PI2-PLG/PLG-Docs/assets/img/about/abt-left-img.jpeg

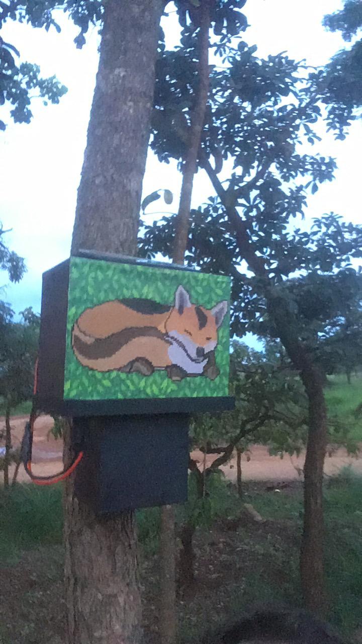
assets/img/about/abt-left-img.jpeg
