PI2-PLG/PLG-Docs/README.md

<p align="center">
  
</p>

# Projeto Lobo-Guará - Docs
### Sistema de monitoramento de queimadas feito por alunos da Universidade de Brasília.

Este repositório é o responsável pela documentação do projeto.
