PI2-PLG/PLG-Docs/Documentos do Projeto/comunicação/README.md

<p align="center">
  
</p>

# Projeto Lobo-Guará - NodeRed
### Sistema de monitoramento de queimadas feito por alunos da Universidade de Brasília.

Este repositório que contém o código de comunicação software-eletrônica.
