PI2-PLG/PLG-Docs/Documentos do Projeto/Eletronica/Esquemáticos/Nobreak_15x20.pdf

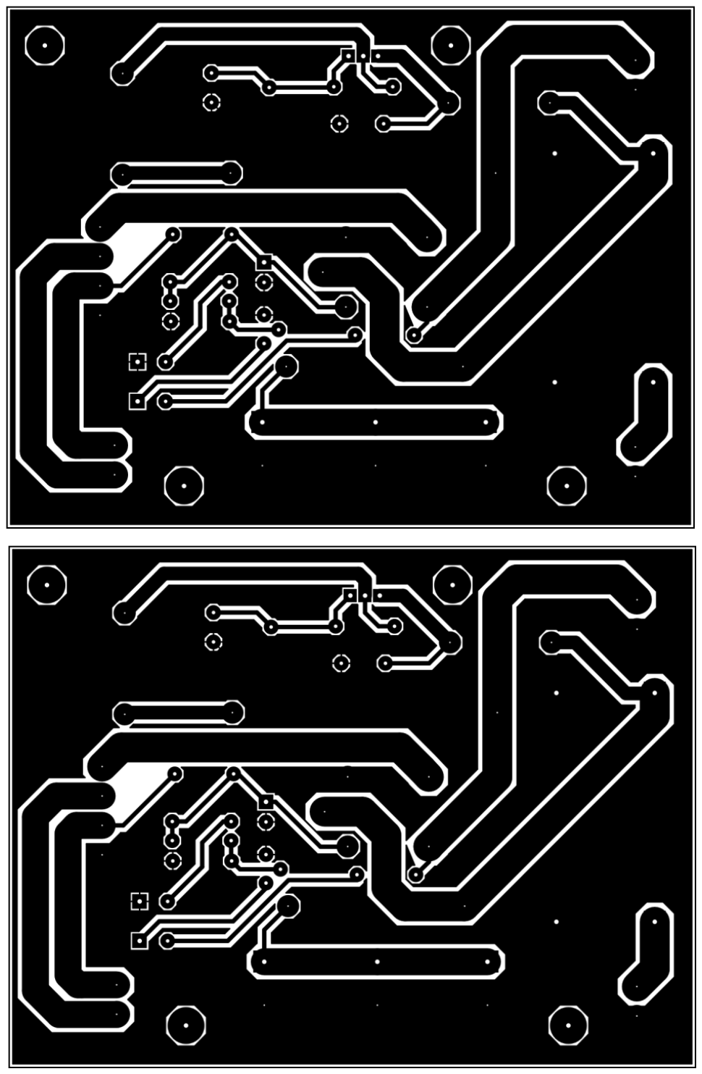
[picture p3: page 1]
