PI2-PLG/PLG-Docs/Documentos do Projeto/Eletronica/Esquemáticos/placa_Principal_15x20.pdf

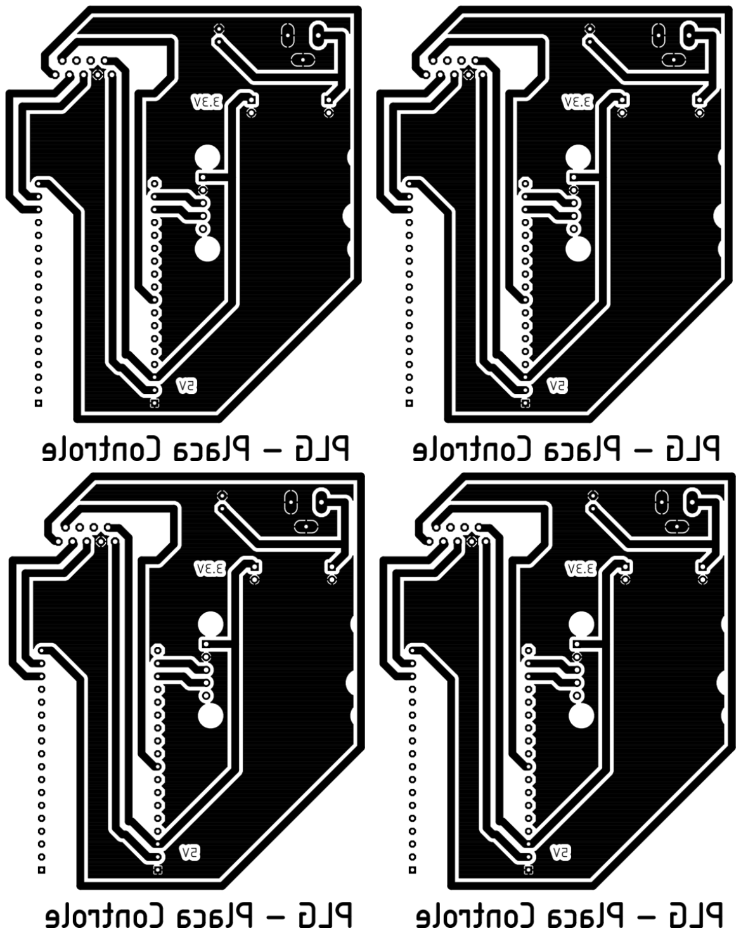
[picture p4: page 1]
