PI2-PLG/PLG-Docs/Documentos do Projeto/Eletronica/Esquemáticos/sensorfinal_15x20.pdf

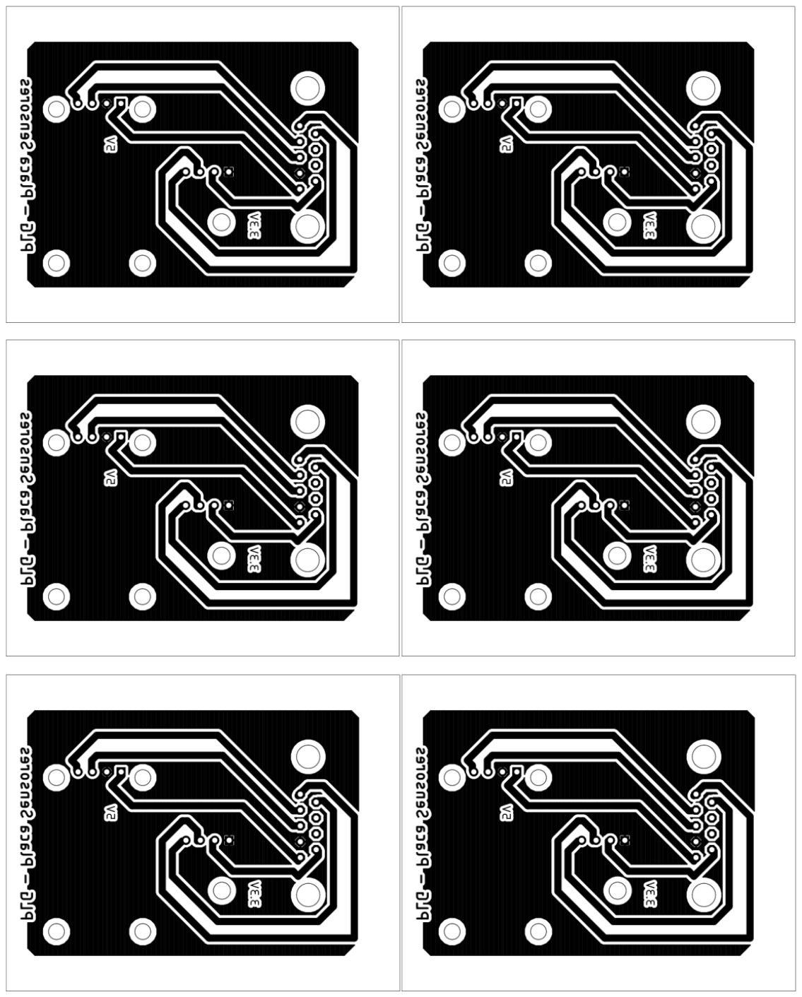
[picture p5: page 1]
