PI2-PLG/PLG-Docs/assets/img/mobile/ft-screen-img.jpg

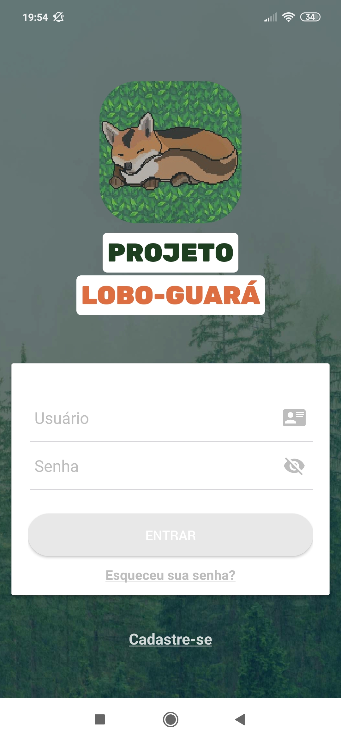
assets/img/mobile/ft-screen-img.jpg
