PI2-PLG/PLG-Docs/assets/img/mobile/screen-slider/chart.jpg

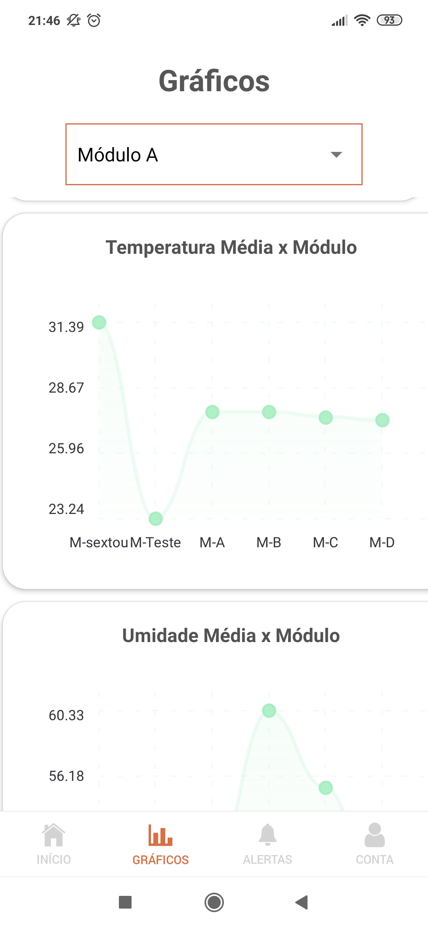
assets/img/mobile/screen-slider/chart.jpg
