PI2-PLG/PLG-Docs/assets/img/mobile/screen-slider/createaccount.jpg

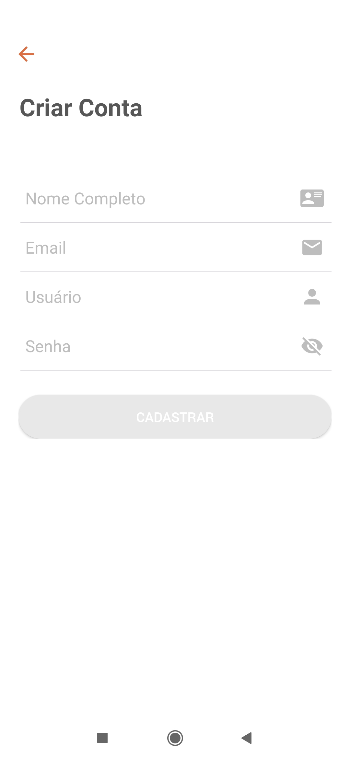
assets/img/mobile/screen-slider/createaccount.jpg
