PI2-PLG/PLG-Docs/assets/img/mobile/screen-slider/profile1.jpg

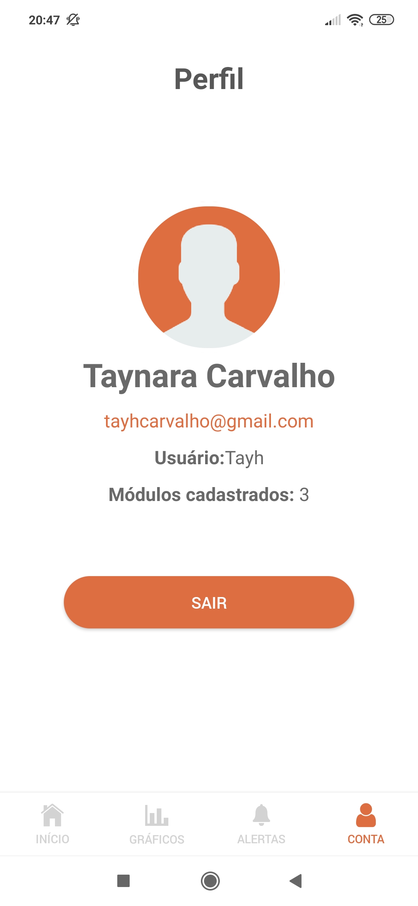
assets/img/mobile/screen-slider/profile1.jpg
