PI2-PLG/PLG-Docs/assets/img/mobile/screen-slider/screen2.jpg

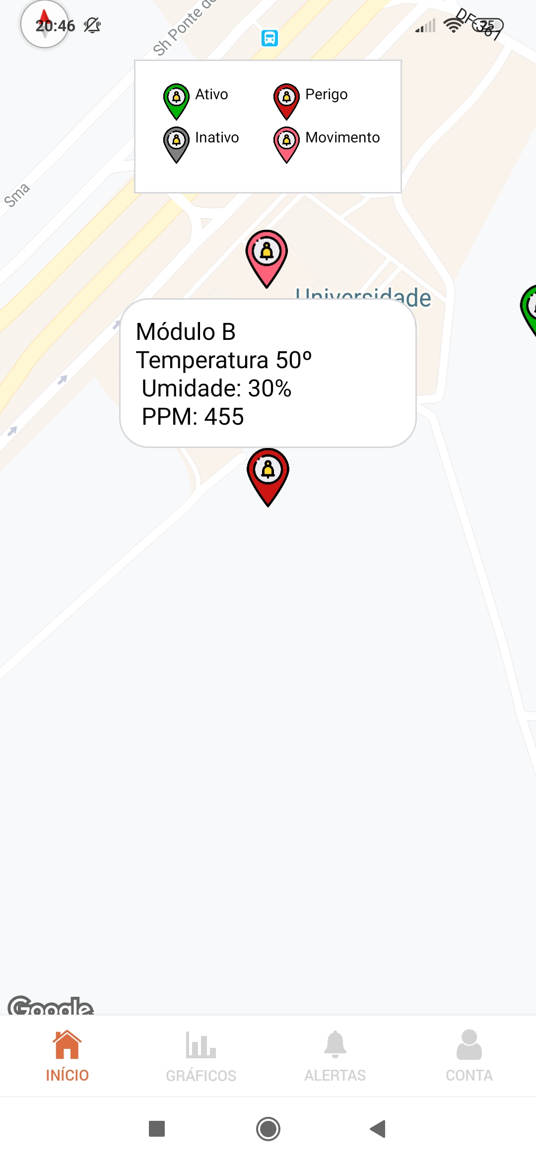
assets/img/mobile/screen-slider/screen2.jpg
