PI2-PLG/PLG-Docs/assets/img/mobile/screen-slider/screen3.jpg

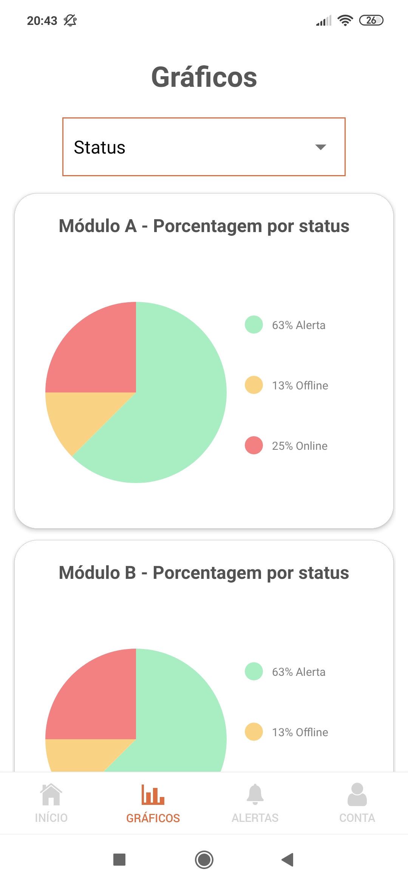
assets/img/mobile/screen-slider/screen3.jpg
