PI2-PLG/PLG-Docs/assets/img/mobile/screen-slider/screen4.jpg

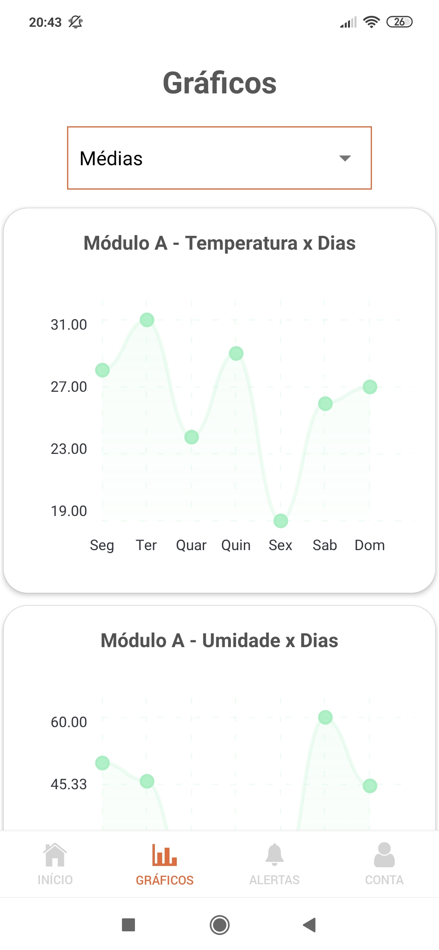
assets/img/mobile/screen-slider/screen4.jpg
