PI2-PLG/PLG-Docs/assets/img/mobile/screen-slider/screen5.jpg

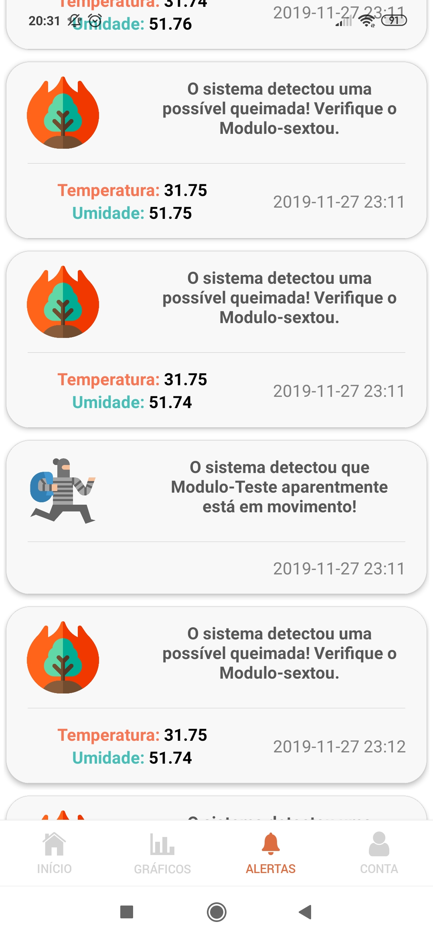
assets/img/mobile/screen-slider/screen5.jpg
