PI2-PLG/PLG-Docs/Documentos do Projeto/Eletronica/D1.png

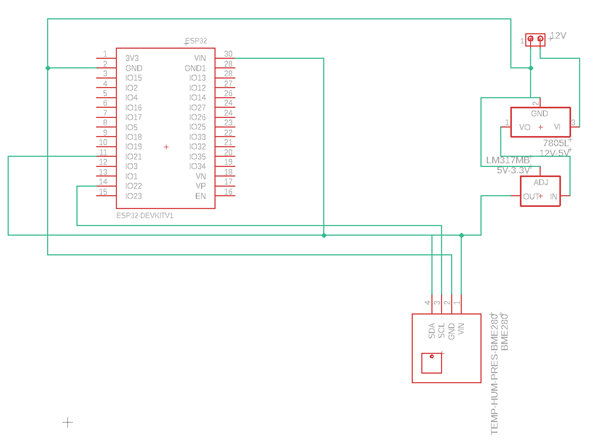
Documentos do Projeto/Eletronica/D1.png
