PI2-PLG/PLG-Docs/Documentos do Projeto/Eletronica/D2.png

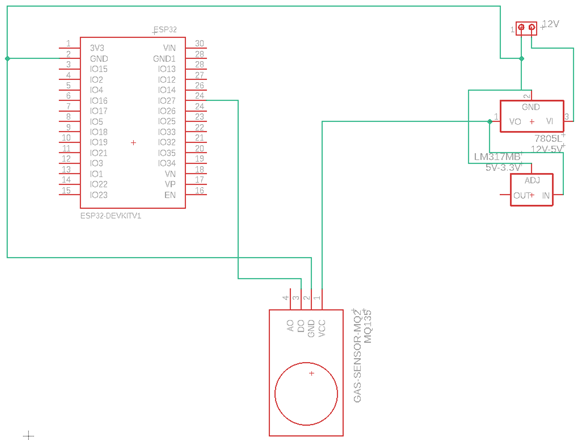
Documentos do Projeto/Eletronica/D2.png
