PI2-PLG/PLG-Docs/Documentos do Projeto/Eletronica/D3.png

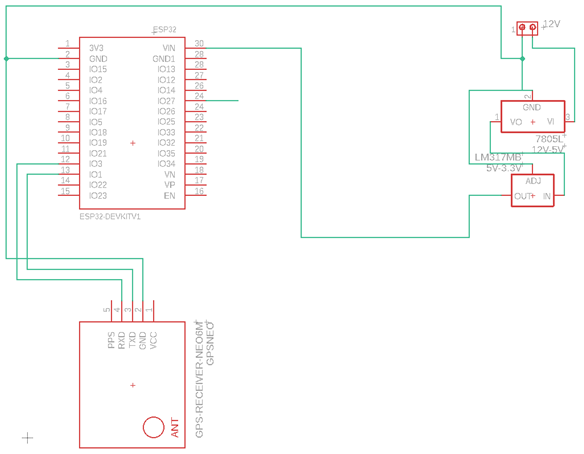
Documentos do Projeto/Eletronica/D3.png
