PI2-PLG/PLG-Docs/Documentos do Projeto/Eletronica/D4.png

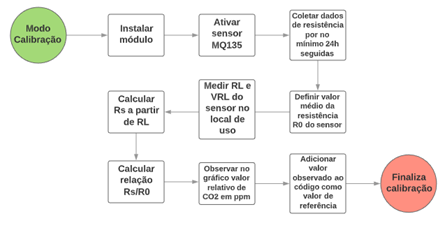
Documentos do Projeto/Eletronica/D4.png
