PI2-PLG/PLG-Docs/Documentos do Projeto/Eletronica/D5.png

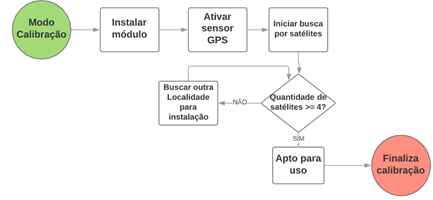
Documentos do Projeto/Eletronica/D5.png
