PI2-PLG/PLG-Docs/Documentos do Projeto/Eletronica/Desing_PCB.jpg

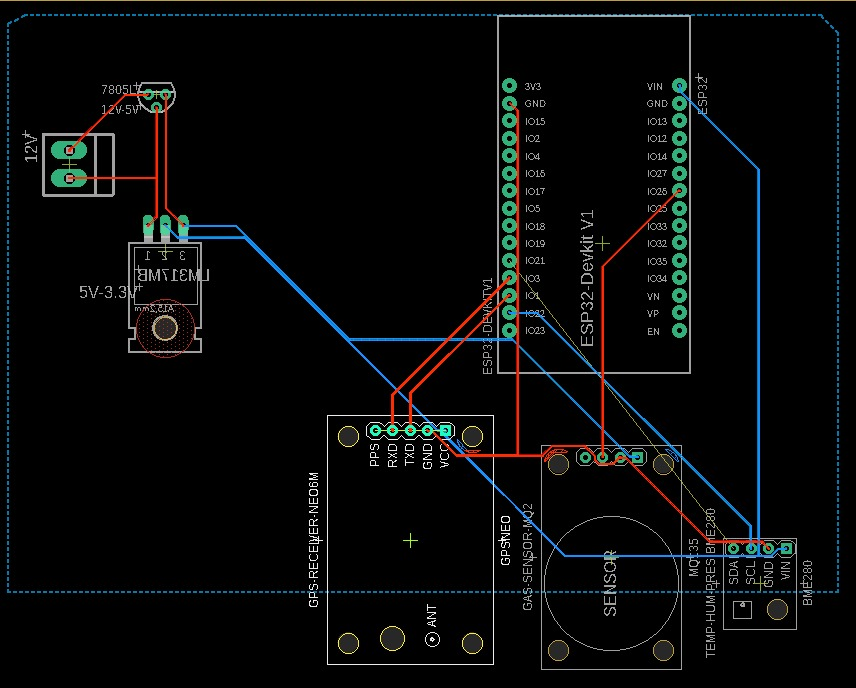
Documentos do Projeto/Eletronica/Desing_PCB.jpg
