PI2-PLG/PLG-Docs/Documentos do Projeto/Eletronica/petri.JPG

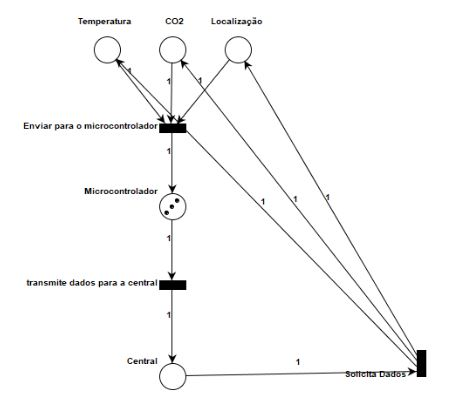
Documentos do Projeto/Eletronica/petri.JPG
