PI2-PLG/PLG-Docs/Documentos do Projeto/Eletronica/vista3D.jpg

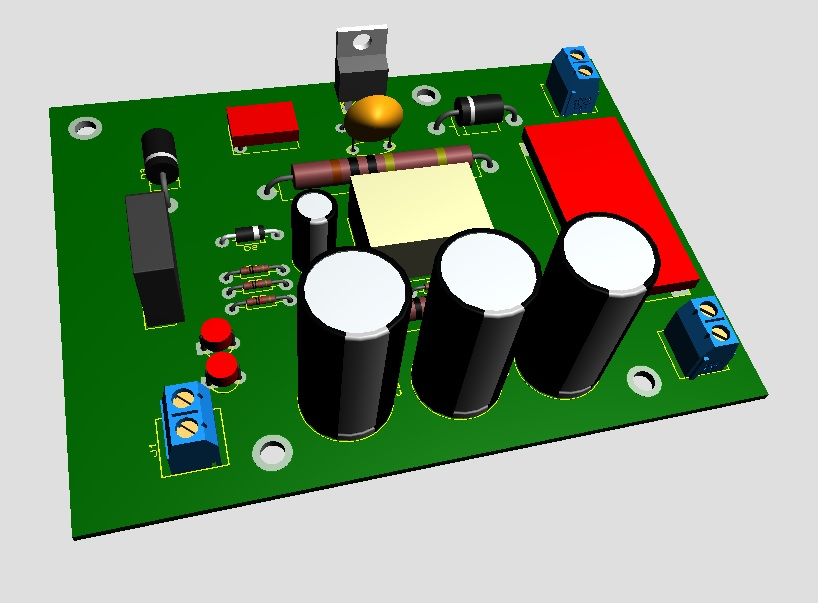
Documentos do Projeto/Eletronica/vista3D.jpg
