PI2-PLG/PLG-Docs/Documentos do Projeto/Energia/Esquemático nobreak.jpg

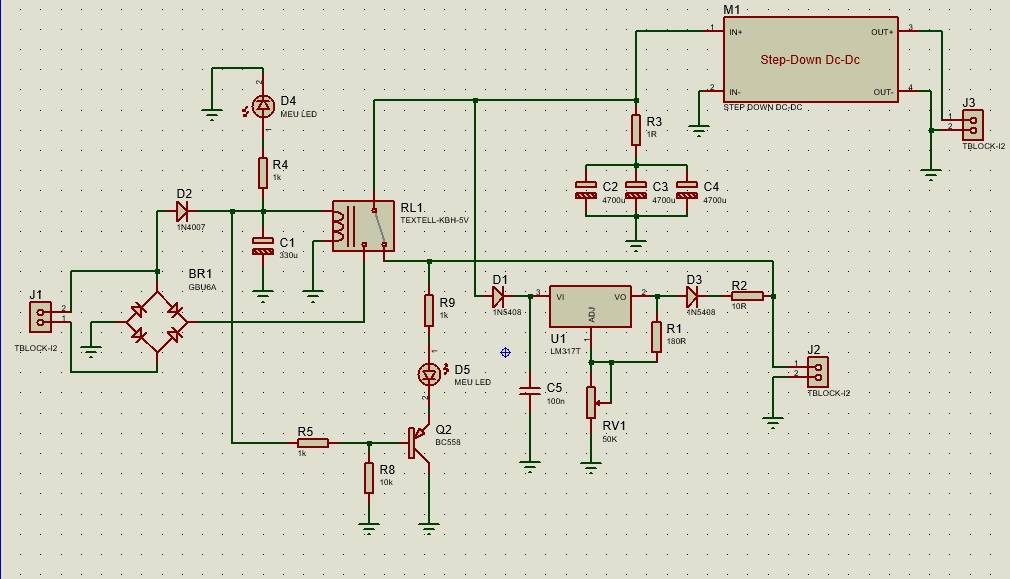
Documentos do Projeto/Energia/Esquemático nobreak.jpg
