PI2-PLG/PLG-Docs/Documentos do Projeto/Energia/Layout placa nobreak.jpg

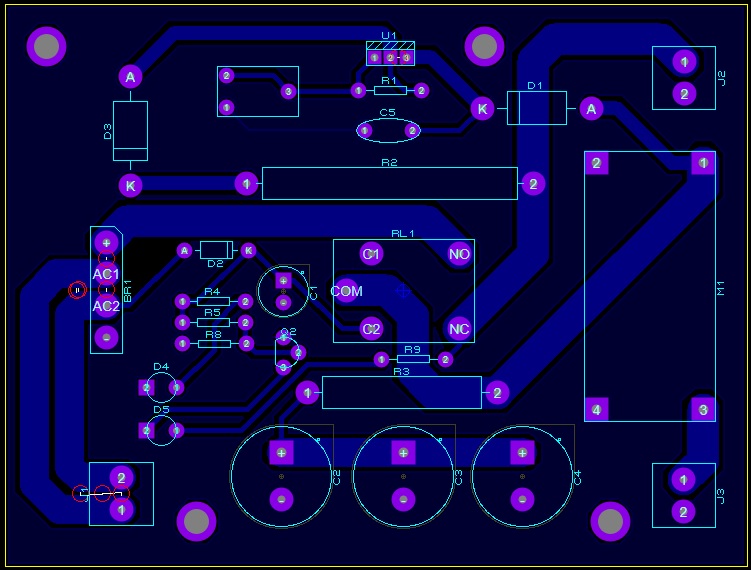
Documentos do Projeto/Energia/Layout placa nobreak.jpg
