PI2-PLG/PLG-Docs/Documentos do Projeto/Energia/Vista lado cobreado placa nobreak.jpg

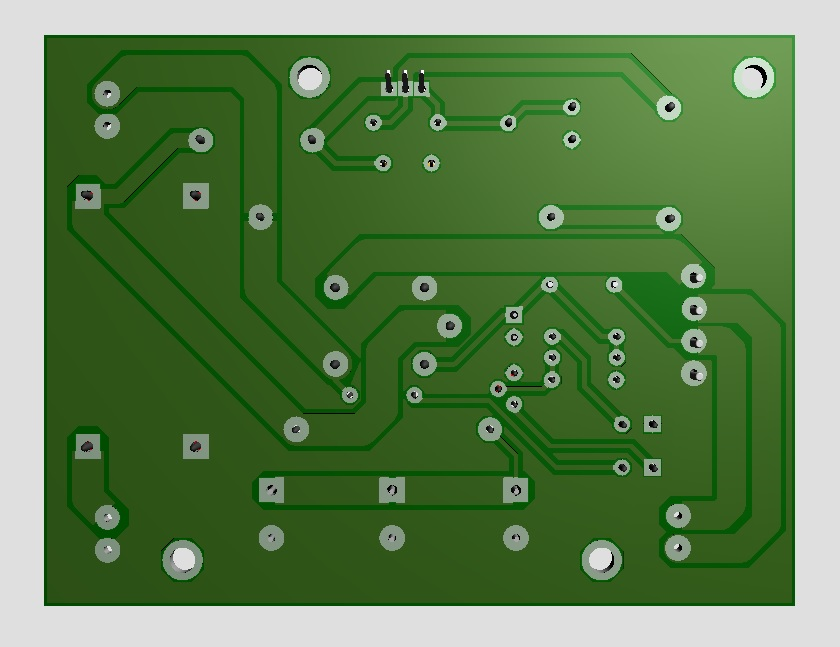
Documentos do Projeto/Energia/Vista lado cobreado placa nobreak.jpg
