PI2-PLG/PLG-Docs/Documentos do Projeto/FolhaDoProduto.png

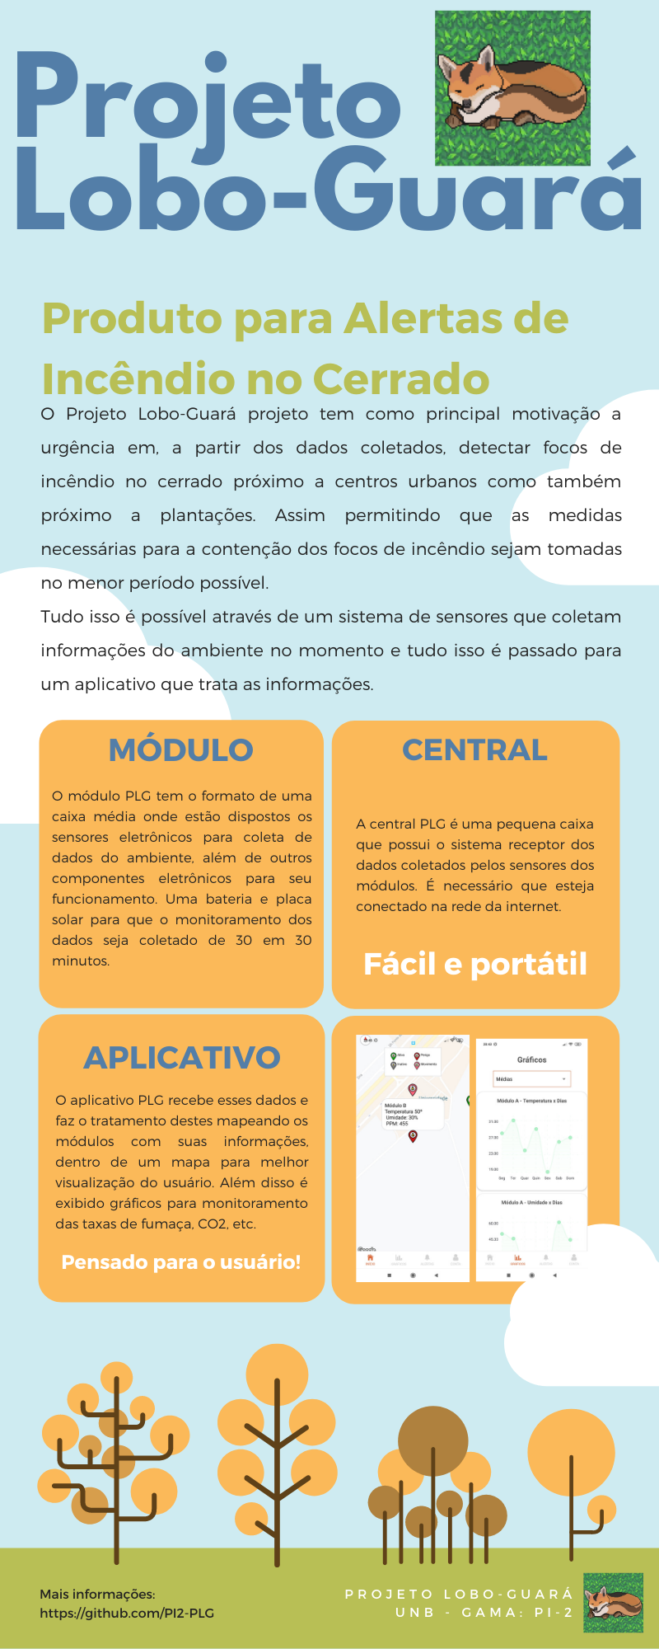
Documentos do Projeto/FolhaDoProduto.png
