PI2-PLG/PLG-Docs/Documentos do Projeto/Projeto Lobo-Guará/Arquitetura.png

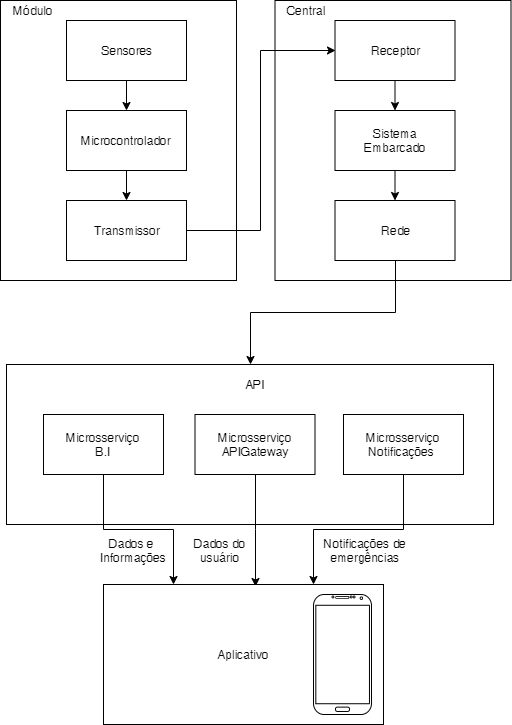
Documentos do Projeto/Projeto Lobo-Guará/Arquitetura.png
