PI2-PLG/PLG-Docs/Documentos do Projeto/Projeto Lobo-Guará/Diagrama Integração PLG.png

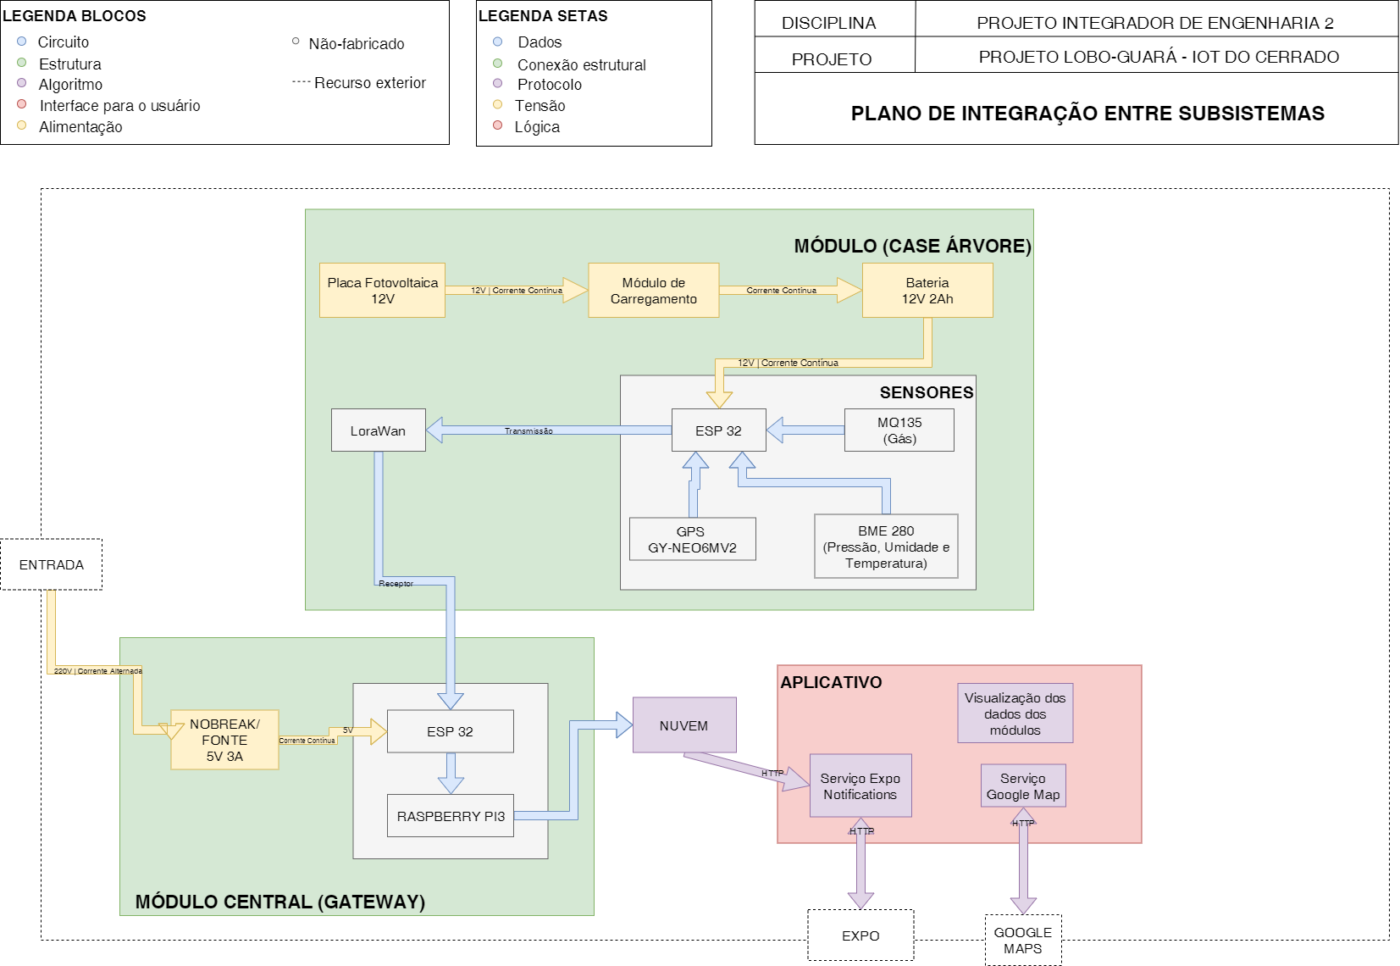
Documentos do Projeto/Projeto Lobo-Guará/Diagrama Integração PLG.png
