PI2-PLG/PLG-Docs/Documentos do Projeto/Projeto Lobo-Guará/EAP.png

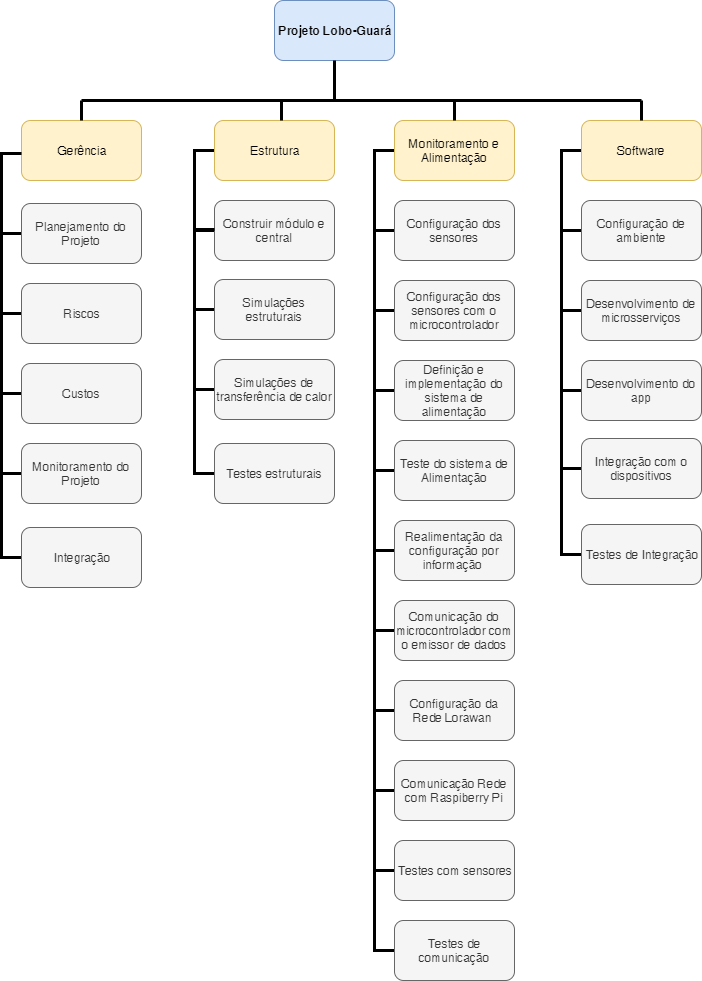
Documentos do Projeto/Projeto Lobo-Guará/EAP.png
