PI2-PLG/PLG-Docs/Documentos do Projeto/Software/Comunicação.png

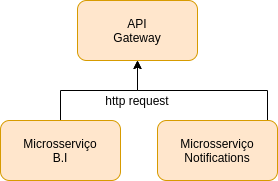
Documentos do Projeto/Software/Comunicação.png
