PI2-PLG/PLG-Docs/Documentos do Projeto/Software/D. Sequência.png

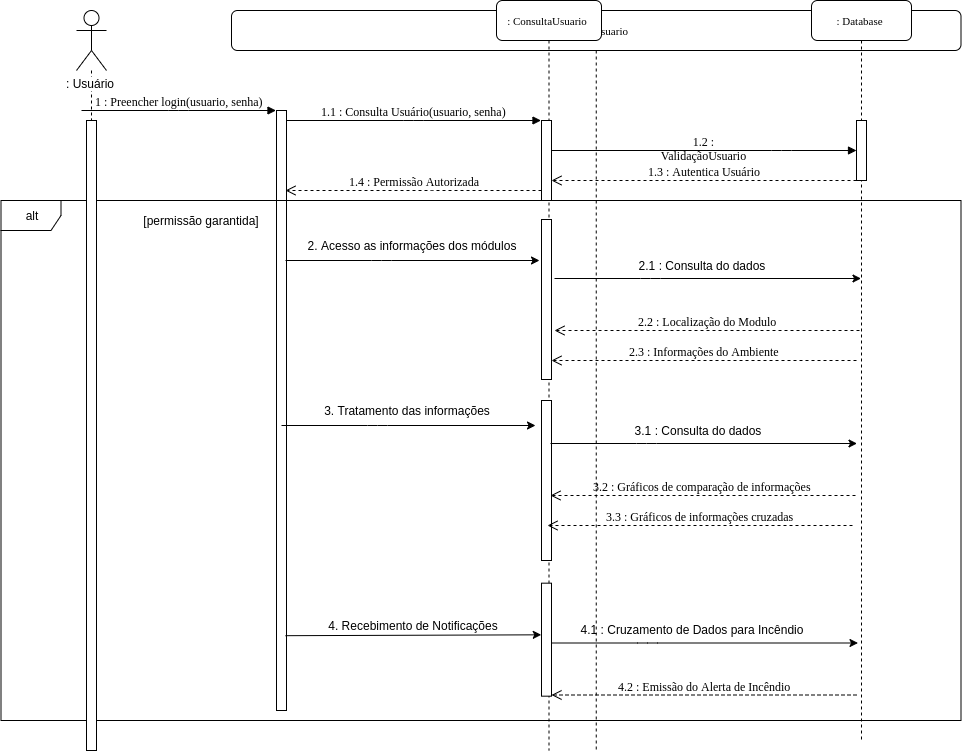
Documentos do Projeto/Software/D. Sequência.png
