PI2-PLG/PLG-Docs/Documentos do Projeto/Software/diagrama_casos_de_uso_lobo_guara.png

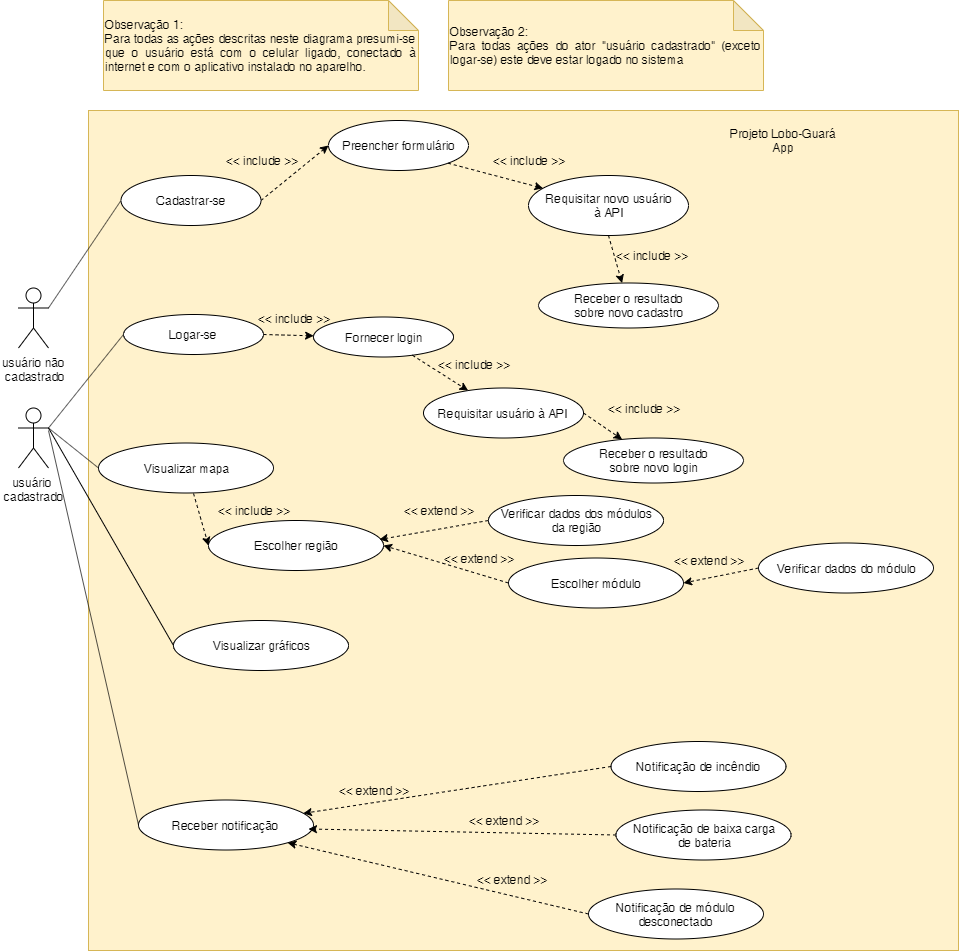
Documentos do Projeto/Software/diagrama_casos_de_uso_lobo_guara.png
