PI2-PLG/PLG-Docs/Documentos do Projeto/Software/diagramaclassesloboguara.png

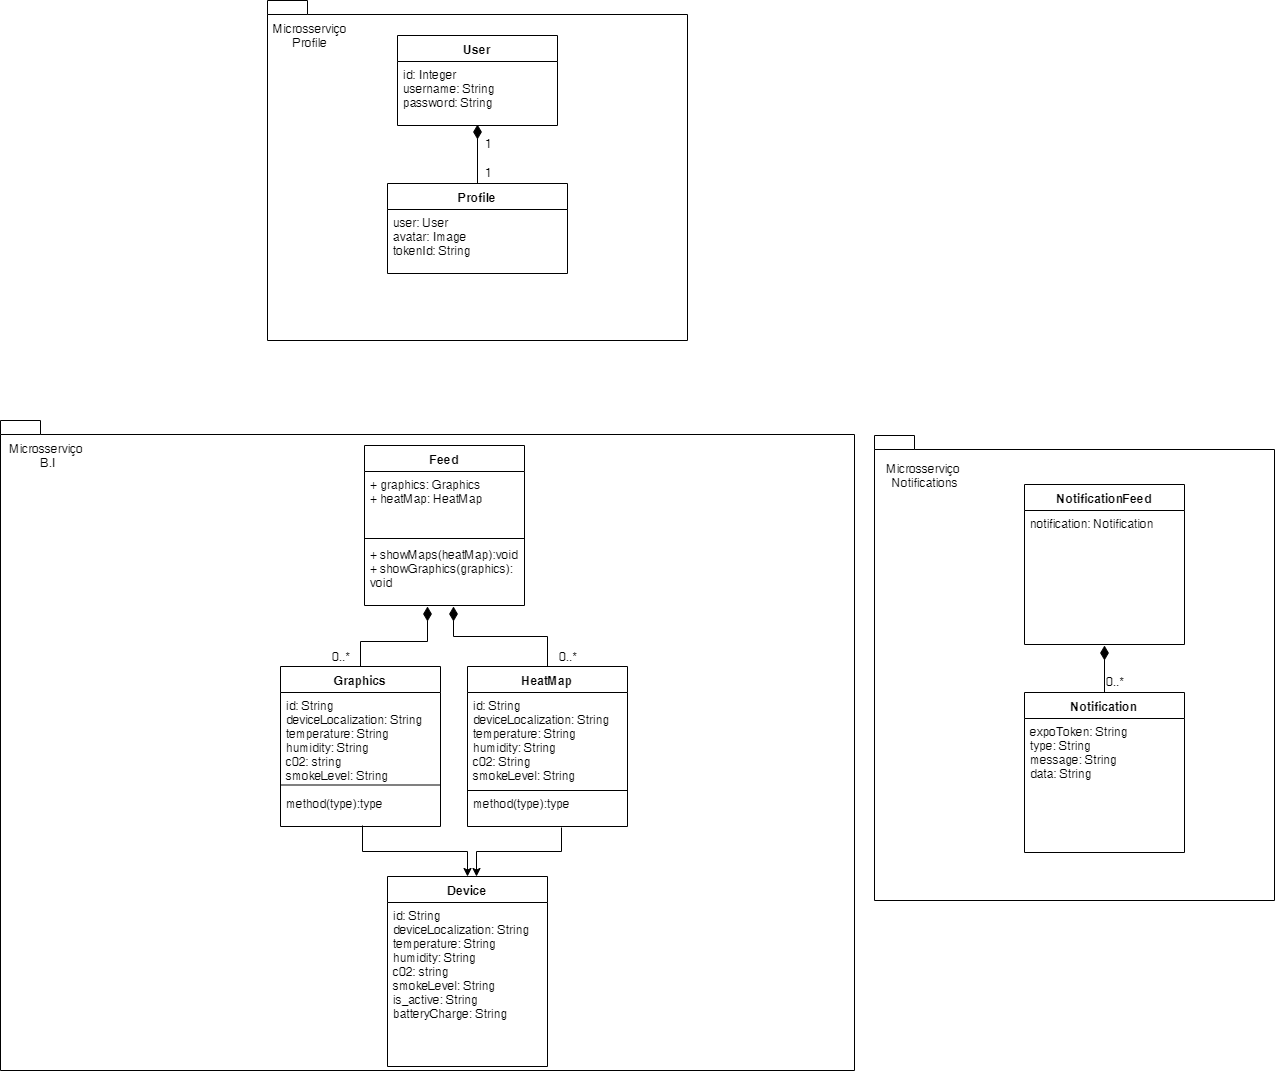
Documentos do Projeto/Software/diagramaclassesloboguara.png
