PI2-PLG/PLG-Docs/Documentos do Projeto/Software/EAP do Produto.png

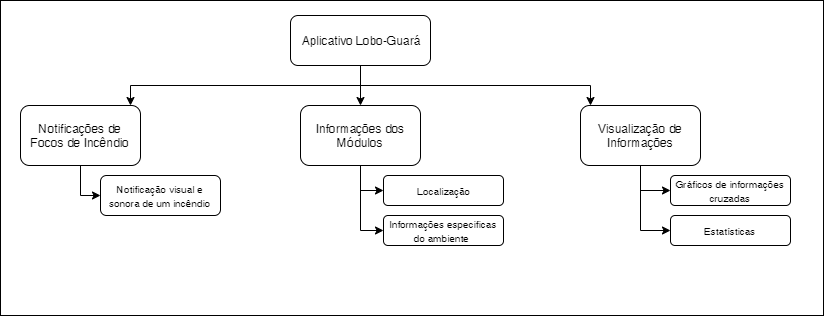
Documentos do Projeto/Software/EAP do Produto.png
