PI2-PLG/PLG-Docs/Documentos do Projeto/Software/integracaosoftwareeletronica.png

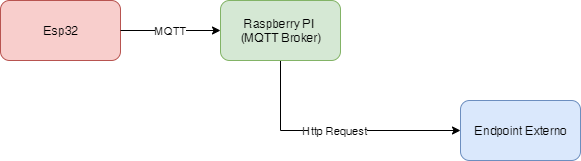
Documentos do Projeto/Software/integracaosoftwareeletronica.png
