PI2-PLG/PLG-Docs/Documentos do Projeto/Software/nfr confiabilidade.png

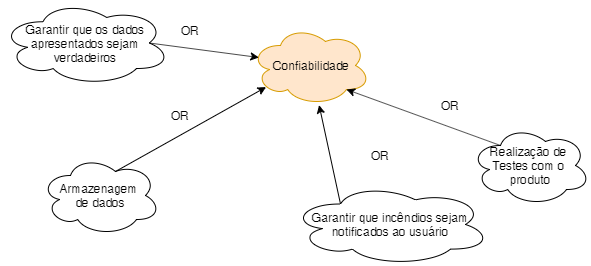
Documentos do Projeto/Software/nfr confiabilidade.png
