PI2-PLG/PLG-Docs/Documentos do Projeto/Software/nfr usabilidade.png

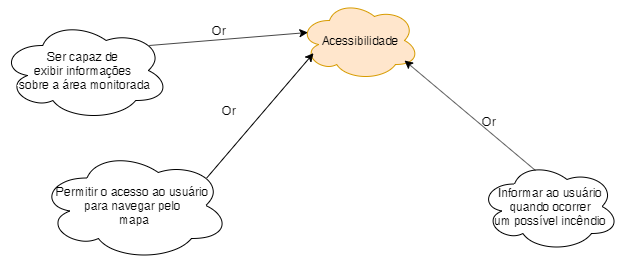
Documentos do Projeto/Software/nfr usabilidade.png
