PI2-PLG/PLG-Docs/Documentos do Projeto/Software/nfrescalabilidade.png

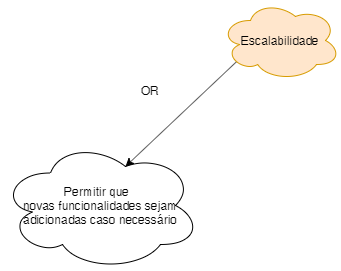
Documentos do Projeto/Software/nfrescalabilidade.png
