PI2-PLG/PLG-Docs/Documentos do Projeto/Software/nfrmanutenabilidade.png

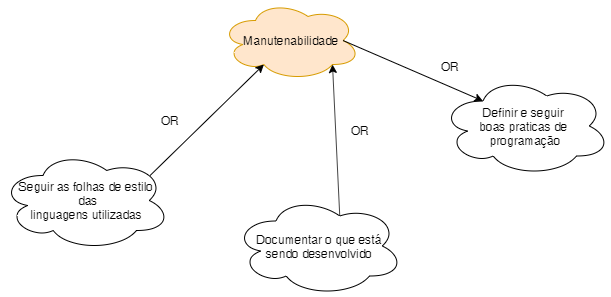
Documentos do Projeto/Software/nfrmanutenabilidade.png
