PI2-PLG/PLG-Docs/Documentos do Projeto/Software/nfrportabilidade.png

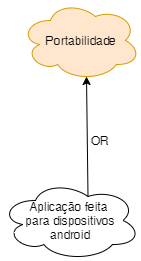
Documentos do Projeto/Software/nfrportabilidade.png
