PI2-PLG/PLG-Docs/Documentos do Projeto/Software/nfrreusabilidade.png

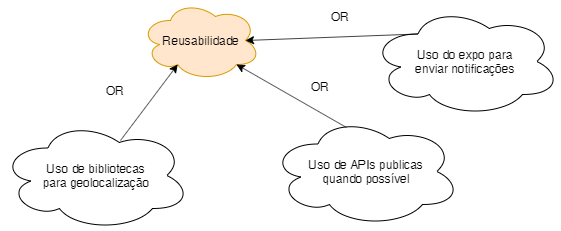
Documentos do Projeto/Software/nfrreusabilidade.png
