PI2-PLG/PLG-Docs/Documentos do Projeto/Software/nfrseguranca.png

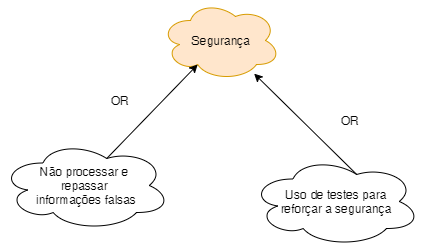
Documentos do Projeto/Software/nfrseguranca.png
