PI2-PLG/PLG-Docs/Documentos do Projeto/Software/nfrusabilidade.png

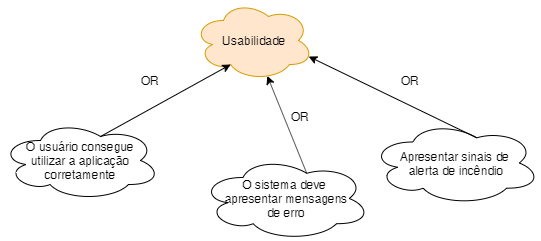
Documentos do Projeto/Software/nfrusabilidade.png
