PI2-PLG/PLG-Docs/Documentos do Projeto/Software/notificationcomunication.png

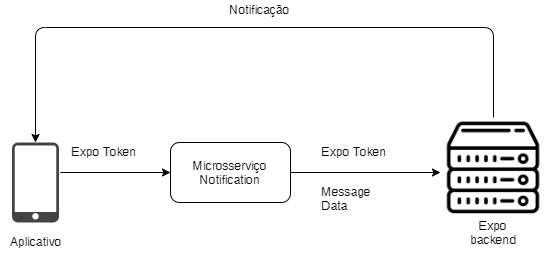
Documentos do Projeto/Software/notificationcomunication.png
