PI2-PLG/PLG-Docs/Documentos do Projeto/Software/nrfdesempenho.png

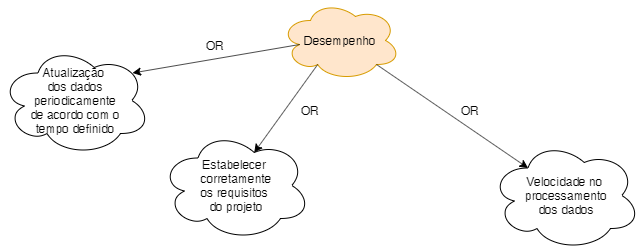
Documentos do Projeto/Software/nrfdesempenho.png
