PI2-PLG/PLG-Docs/Documentos do Projeto/Software/Untitled Diagram.png

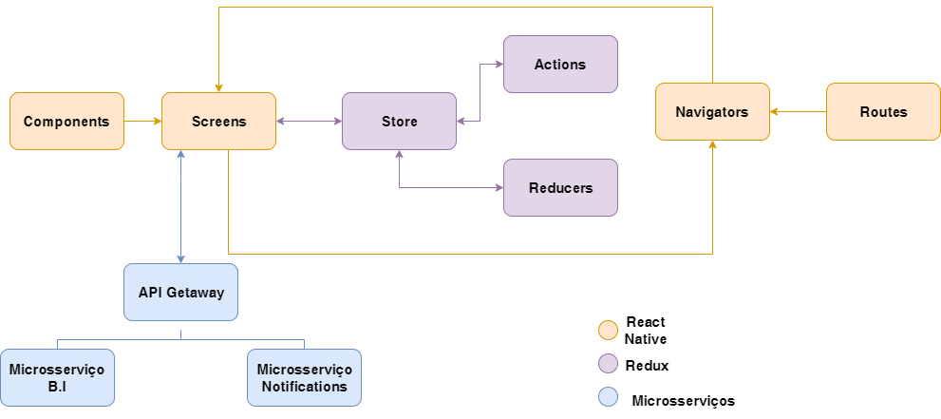
Documentos do Projeto/Software/Untitled Diagram.png
