PI2-PLG/PLG-Docs/Documentos do Projeto/Estrutura/CAD SolidWorks/Modulovedado.SLDASM

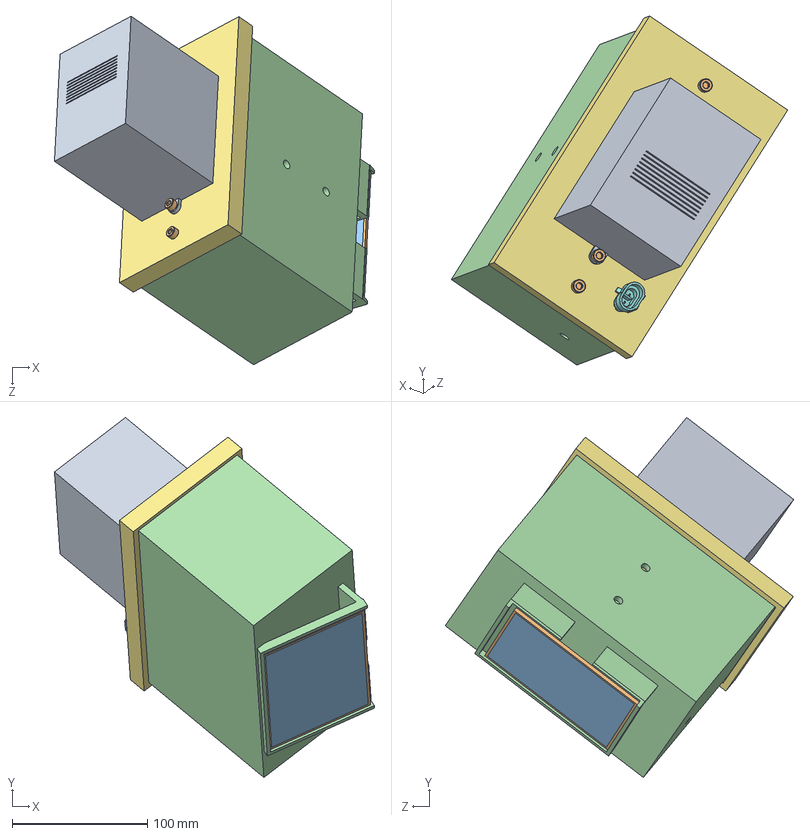
[picture p47: CAD file, 2019-12-05]
Documentos do Projeto/Estrutura/CAD SolidWorks/Modulovedado.SLDASM
237.1 x 266.6 x 258.1 mm
Bateria
molduraplacasolar
placasolar
caixamodulo - Com suportepra plca
placaCircuito
placa2
fundovedado
c-282104-1-b-3d
portasensor
M5 x 0.8mm Thread 30mm LONG SOCKET HEAD CAP SCREW x 4
