PI2-PLG/PLG-Docs/Documentos do Projeto/Estrutura/CAD STEP/c-282104-1-b-3d.STEP

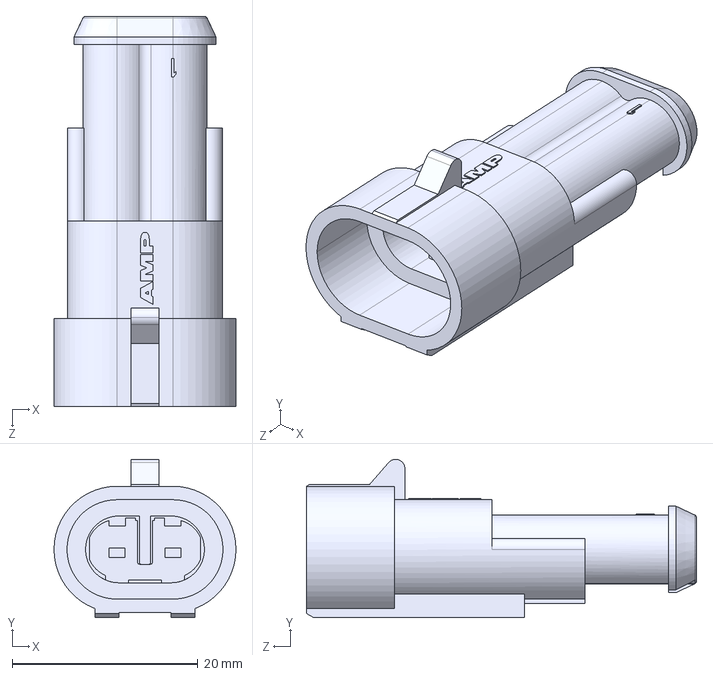
[picture p48: CAD file, 2019-12-05]
Documentos do Projeto/Estrutura/CAD STEP/c-282104-1-b-3d.STEP
19.6 x 17.0 x 42.0 mm
