PI2-PLG/PLG-Docs/Documentos do Projeto/Estrutura/CAD STEP/placasensor.STEP

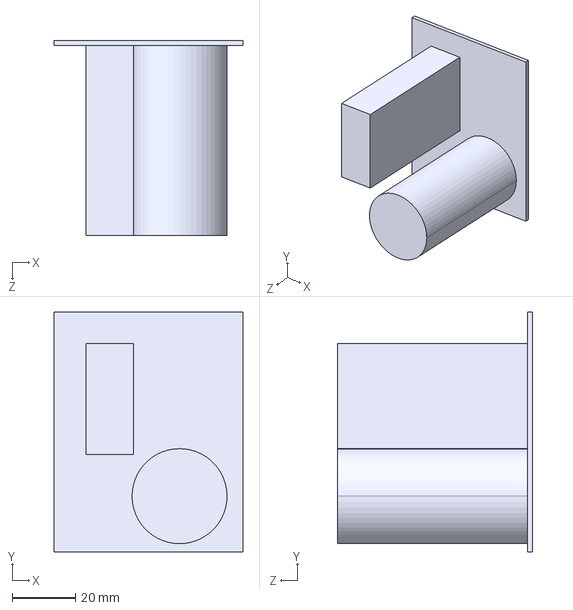
[picture p49: CAD file, 2019-12-05]
Documentos do Projeto/Estrutura/CAD STEP/placasensor.STEP
59.6 x 75.8 x 61.7 mm
