PI2-PLG/PLG-Docs/Documentos do Projeto/Estrutura/CAD STEP/placasolar.STEP

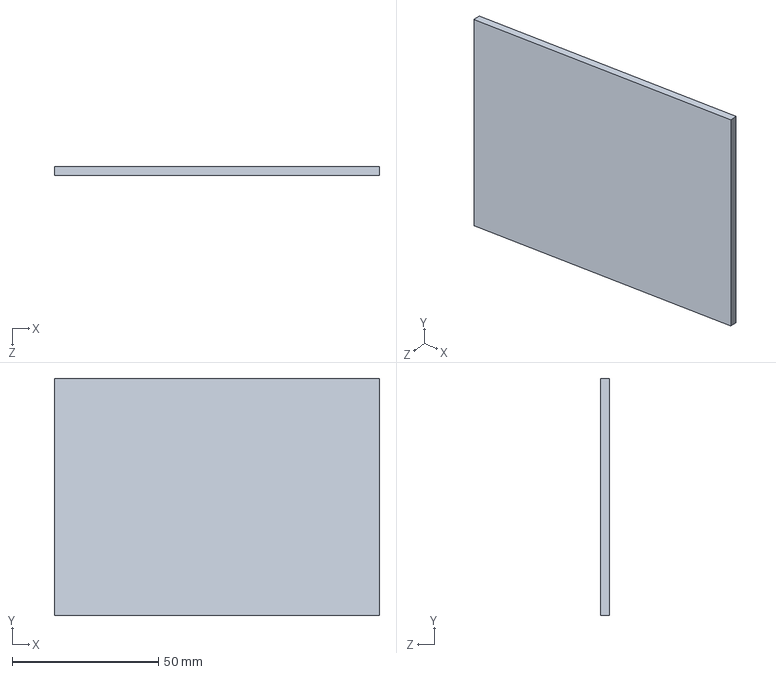
[picture p50: CAD file, 2019-12-05]
Documentos do Projeto/Estrutura/CAD STEP/placasolar.STEP
111.0 x 81.0 x 3.00 mm
