PI2-PLG/PLG-Docs/Documentos do Projeto/Estrutura/CAD STEP/portasensor.STEP

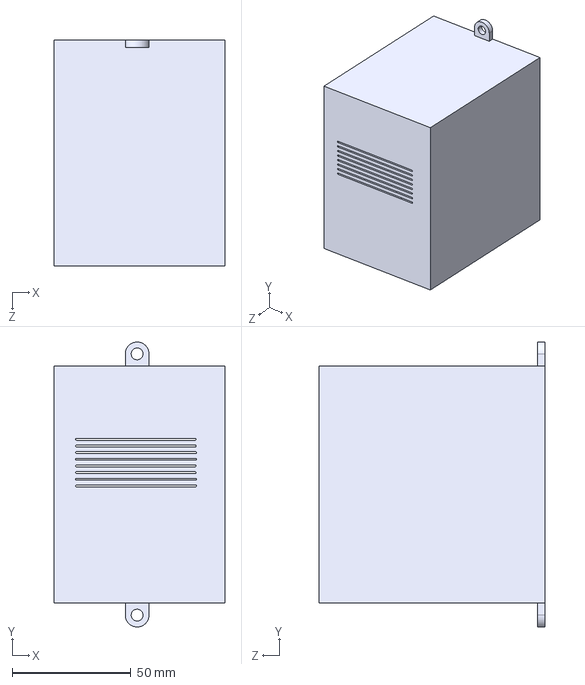
[picture p51: CAD file, 2019-12-05]
Documentos do Projeto/Estrutura/CAD STEP/portasensor.STEP
72.0 x 120.0 x 95.0 mm
