PI2-PLG/PLG-Docs/Documentos do Projeto/Estrutura/CAD STEP/caixamodulo - Com suportepra plca.STEP

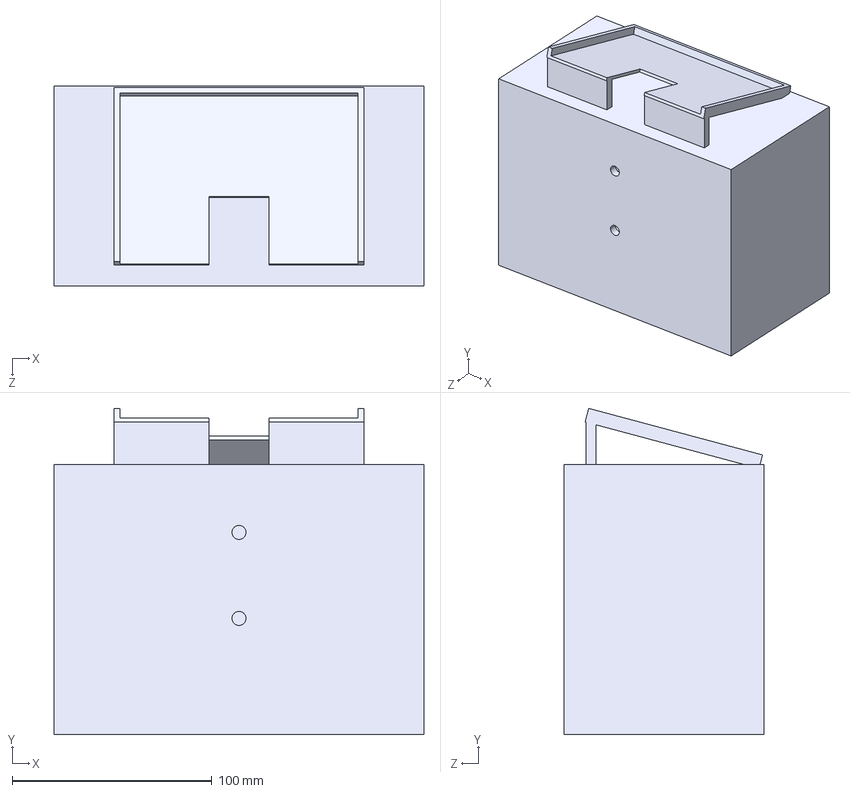
[picture p52: CAD file, 2019-12-05]
Documentos do Projeto/Estrutura/CAD STEP/caixamodulo - Com suportepra plca.STEP
185.0 x 163.1 x 100.0 mm
