PI2-PLG/PLG-Docs/Documentos do Projeto/Estrutura/CAD STEP/Bateria.STEP

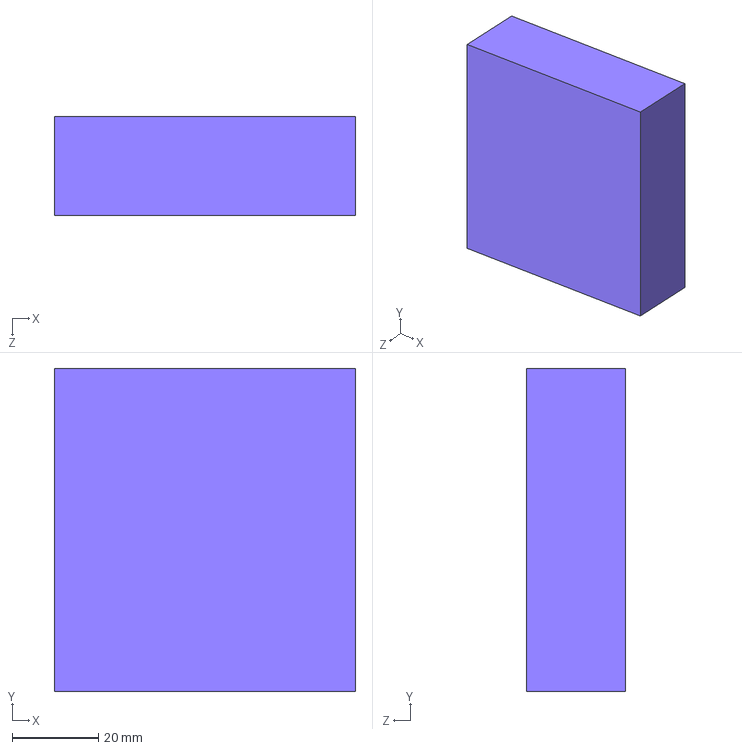
[picture p53: CAD file, 2019-12-05]
Documentos do Projeto/Estrutura/CAD STEP/Bateria.STEP
70.0 x 75.0 x 23.0 mm
