PI2-PLG/PLG-Docs/Documentos do Projeto/Estrutura/CAD STEP/placaCircuito.STEP

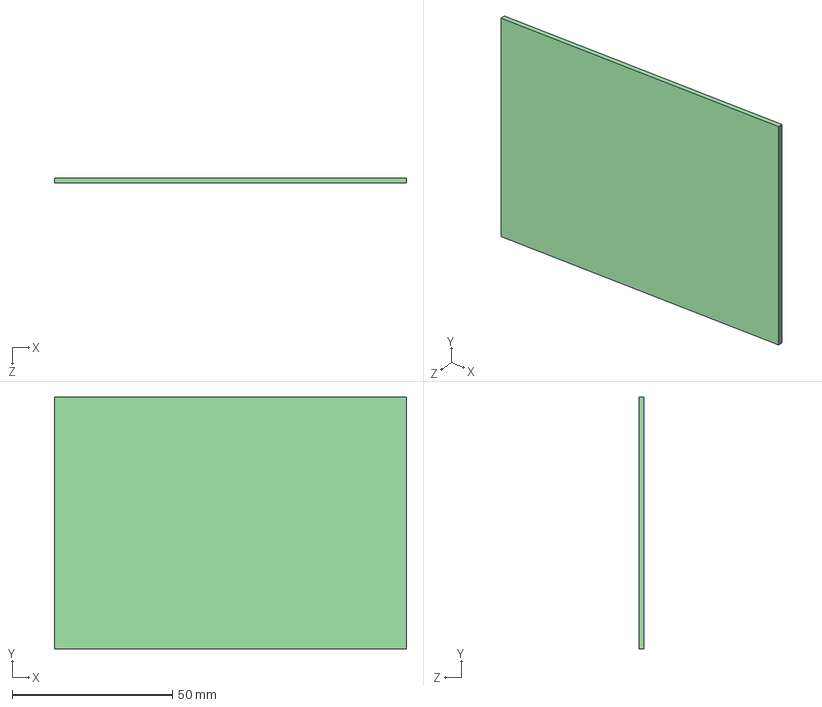
[picture p54: CAD file, 2019-12-05]
Documentos do Projeto/Estrutura/CAD STEP/placaCircuito.STEP
110.0 x 78.7 x 1.70 mm
