PI2-PLG/PLG-Docs/Documentos do Projeto/Estrutura/CAD STEP/placa2.STEP

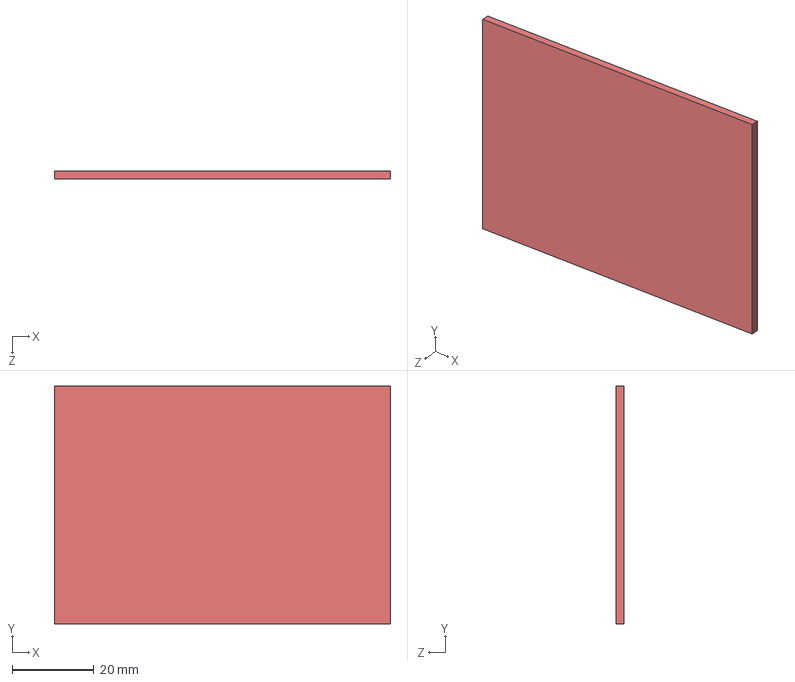
[picture p55: CAD file, 2019-12-05]
Documentos do Projeto/Estrutura/CAD STEP/placa2.STEP
82.0 x 58.0 x 2.00 mm
