PI2-PLG/PLG-Docs/Documentos do Projeto/Estrutura/CAD STEP/molduraplacasolar.STEP

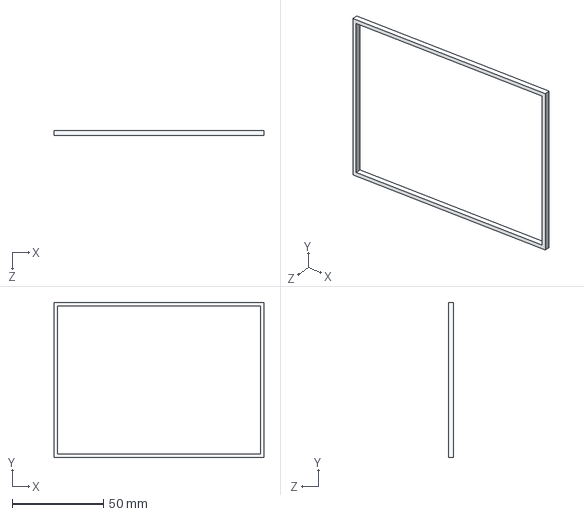
[picture p56: CAD file, 2019-12-05]
Documentos do Projeto/Estrutura/CAD STEP/molduraplacasolar.STEP
115.0 x 85.0 x 3.00 mm
