PI2-PLG/PLG-Docs/Documentos do Projeto/Estrutura/CAD STEP/fundovedado.STEP

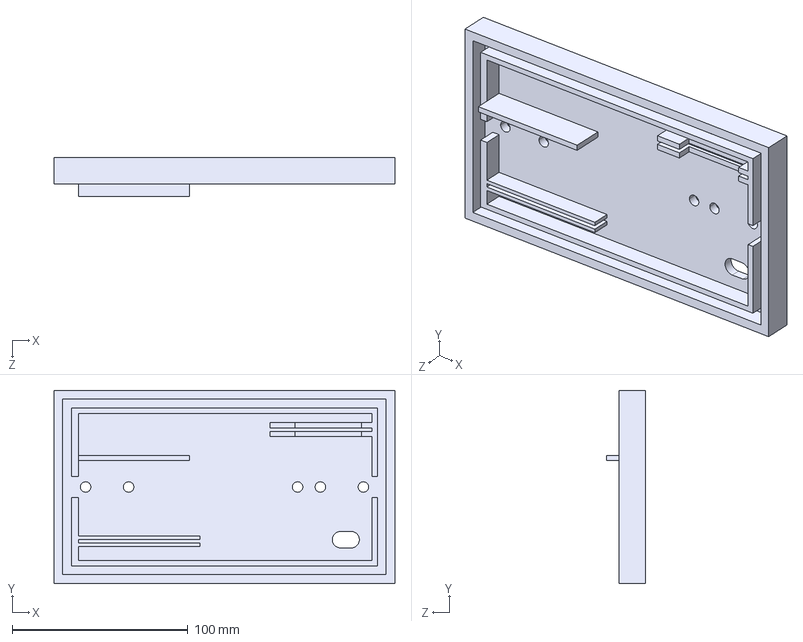
[picture p57: CAD file, 2019-12-05]
Documentos do Projeto/Estrutura/CAD STEP/fundovedado.STEP
194.2 x 110.0 x 22.0 mm
