PI2-PLG/PLG-Docs/(list of files, cad)

Other CAD files:
Documentos do Projeto/Estrutura/CAD SolidWorks/Bateria.SLDPRT
Documentos do Projeto/Estrutura/CAD SolidWorks/c-282104-1-b-3d.SLDPRT
Documentos do Projeto/Estrutura/CAD SolidWorks/caixamodulo - Com suportepra plca.SLDPRT
Documentos do Projeto/Estrutura/CAD SolidWorks/fundovedado.SLDPRT
Documentos do Projeto/Estrutura/CAD SolidWorks/molduraplacasolar.SLDPRT
Documentos do Projeto/Estrutura/CAD SolidWorks/placa2.SLDPRT
Documentos do Projeto/Estrutura/CAD SolidWorks/placaCircuito.SLDPRT
Documentos do Projeto/Estrutura/CAD SolidWorks/placasensor.SLDPRT
Documentos do Projeto/Estrutura/CAD SolidWorks/placasolar.SLDPRT
Documentos do Projeto/Estrutura/CAD SolidWorks/portasensor.SLDPRT
