PI2-PLG/PLG-Docs/Documentos do Projeto/Eletronica/manufacturing_bottonside.jpg

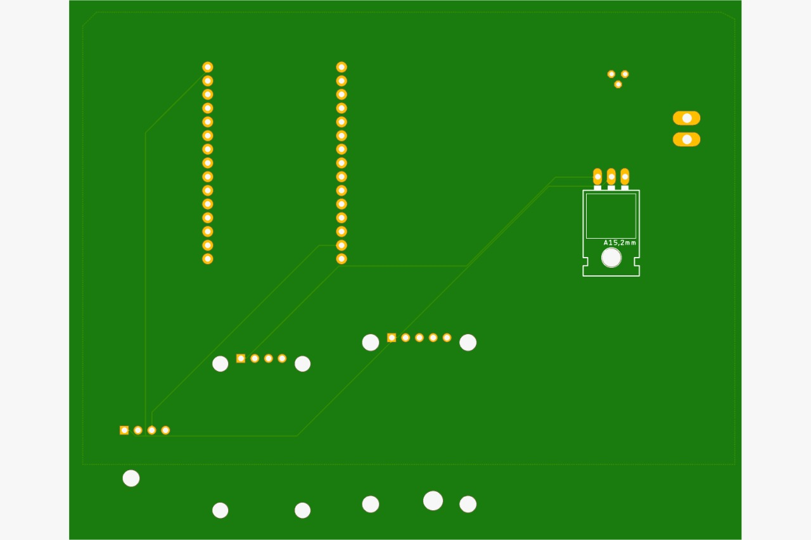
Documentos do Projeto/Eletronica/manufacturing_bottonside.jpg
