PI2-PLG/PLG-Docs/Documentos do Projeto/Eletronica/manufacturing_topside.jpg

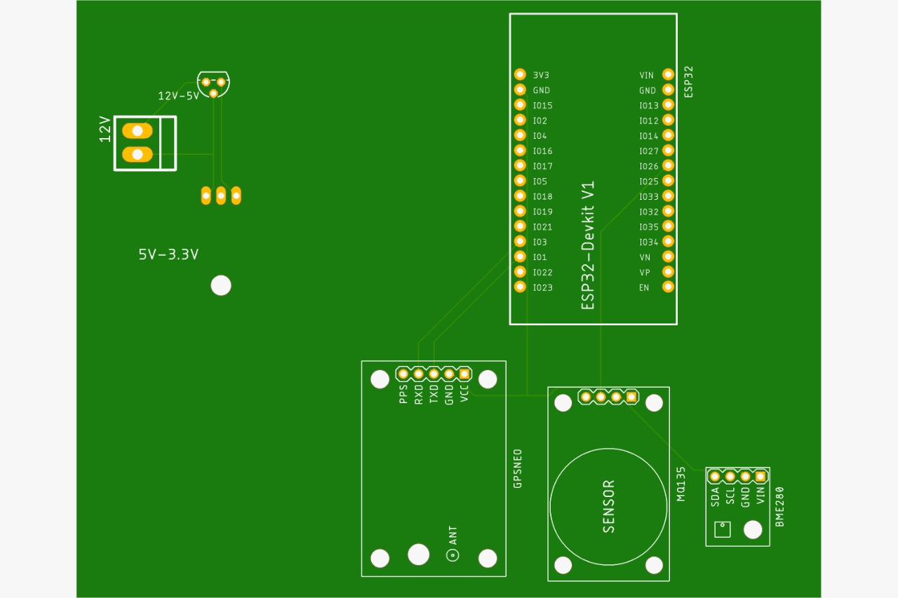
Documentos do Projeto/Eletronica/manufacturing_topside.jpg
