PI2-PLG/PLG-Docs/Documentos do Projeto/Software/nfrperformance.png

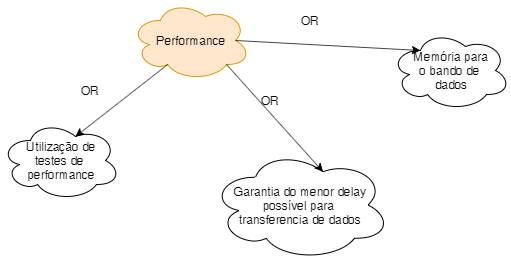
Documentos do Projeto/Software/nfrperformance.png
