PI2-PLG/PLG-Docs/(threads)

Thread 1 (2019-09-16):

Criar digrama de classe

tayh, 2019-09-16:
**Descrição**
Fazer o diagrama de classe incluindo todos os microsserviços

**Tarefas**

- [ ] O diagrama tem que ter as classes necessárias par ao porjeto
- [ ] Cardinalidades entre classes
- [ ] Heranças e etc

**Critérios de Aceitação**

Thread 2 (2019-09-16):

Criar diagrama de casos de uso

tayh, 2019-09-16:
**Descrição**
Criar diagrama de caso de uso que represente o projeto

**Tarefas**

- [ ] O diagrama deve possuir os atores do sistema
- [ ] O diagrama deve possuir os casos de uso
- [ ] O diagrama deve possuir a comunicação entre os atores e casos de uso (Cardinalidade, herança, ligações e etc)

**Critérios de Aceitação**

Thread 3 (2019-09-16):

Criar digrama de sequência

tayh, 2019-09-16:
**Descrição**
Fazer o diagrama de classe para descrever as sequências do processo do projeto

**Tarefas**

- [ ] O diagrama deve possuir os atores do sistema
- [ ] O diagrama deve possuir os objetos do sistema
- [ ] O diagrama deve possuir as sequência (retorno, linha de vida foco de controle e etc) do sistema

**Critérios de Aceitação**

Thread 5 (2019-09-21):

Configurar ambiente

tayh, 2019-09-21:
**Descrição**

Configurar o ambiente usando Docker.

**Tarefas**

- [x] Criar Dockerfile e docker-compose.yml
- [x] Criar projeto em djago
- [x] Fazer configuração necessárias para os repositórios (ex: .gitignore)

**Critérios de Aceitação**
A configuração de todos os repositórios deve ser padronizada

tayh, 2019-09-21:
Ambiente configurado, parabéns!

Closed 2019-09-21.

Thread 6 (2019-09-21):

Configurar Integração Contínua

tayh, 2019-09-21:
**Descrição**
User o gitlab CI para fazer a configuração da integração contínua

**Tarefas**

- [x] Integrar o gitlab-ci com os repositório do github
- [x] Criar arquivo .gitlab-ci.yml
- [x] Configurar a build

**Critérios de Aceitação**
Todos os repositório devem estar padronizados

tayh, 2019-09-21:
Integração contínua configurada.

Closed 2019-09-21.
