PI2-PLG/PLG-Docs/Documentos do Projeto/Estrutura/Desenhos/Compartimento Sensores.PDF

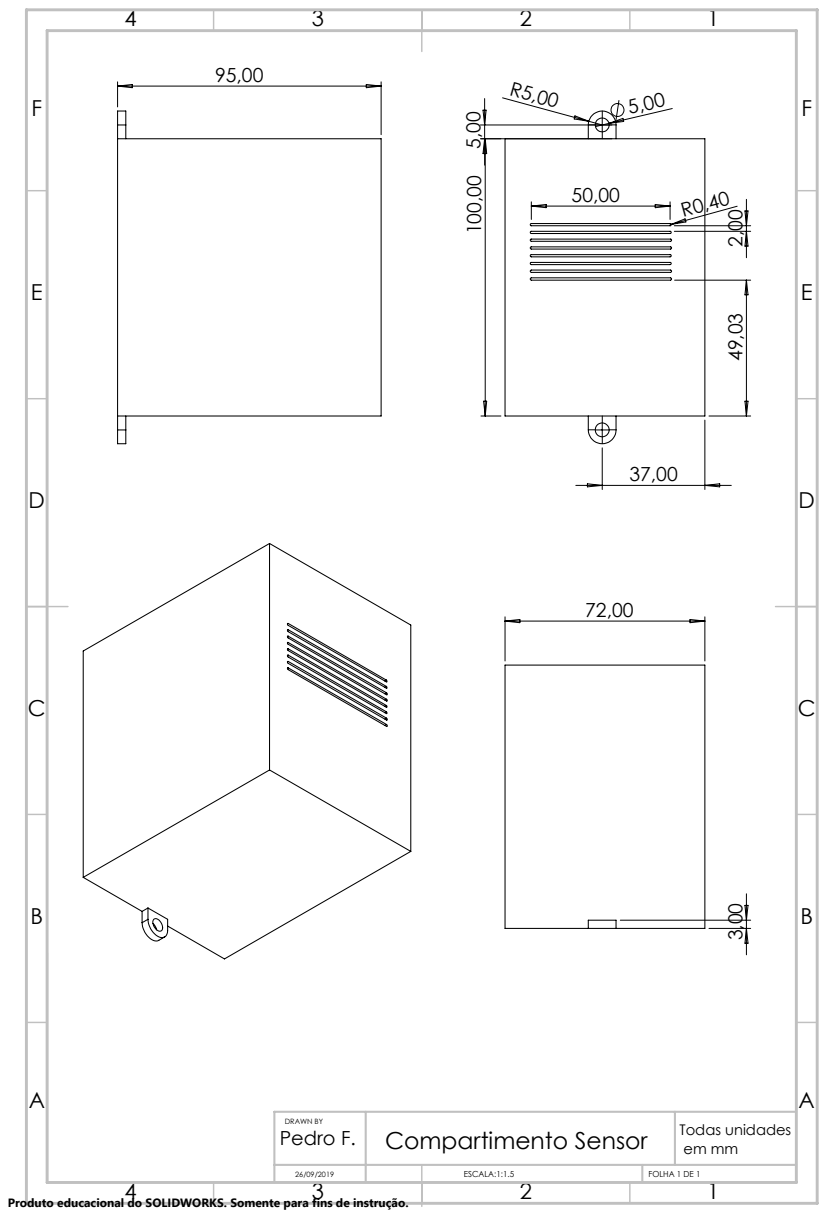
[picture p61: page 1]

DRAWN BY Pedro F. | Compartimento Sensor | Todas unidades em mm

26/09/2019 | | ESCALA:1:1.5 | FOLHA 1 DE 1

Produto educacional do SOLIDWORKS. Somente para fins de instrução.
