PI2-PLG/PLG-Docs/Documentos do Projeto/Estrutura/Desenhos/Vista Explodida.PDF

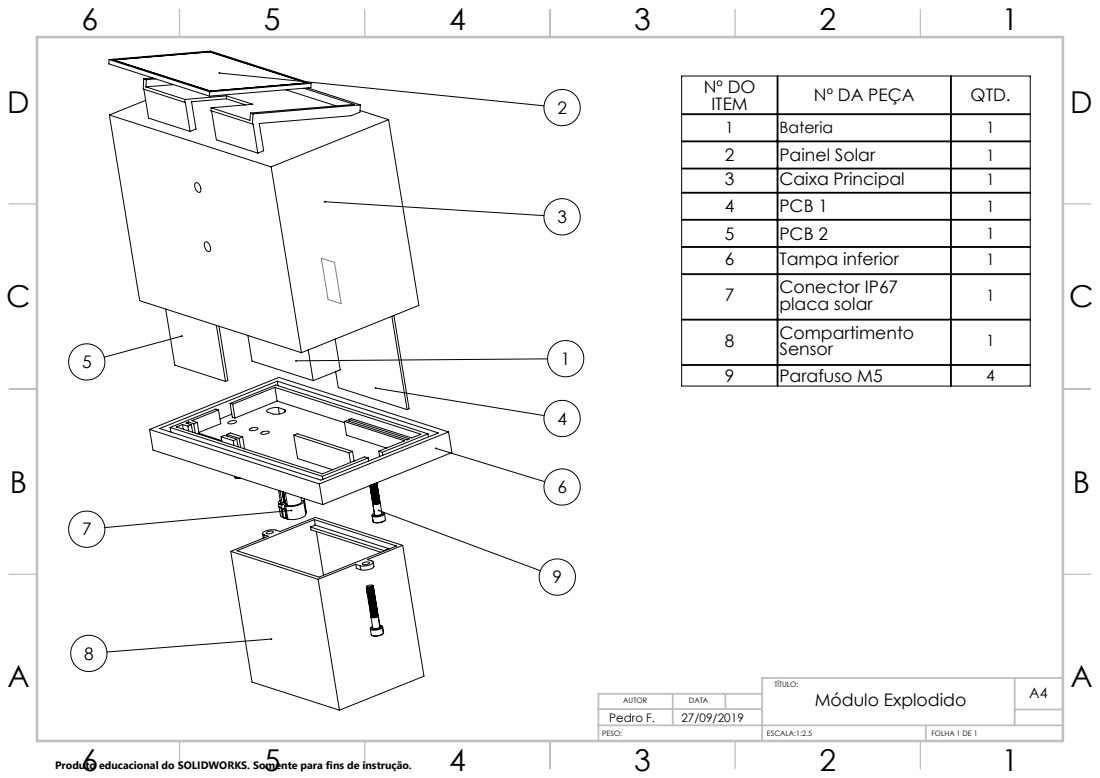
[picture p62: page 1]

Nº DO ITEM | Nº DA PEÇA | QTD.

1 | Bateria | 1
2 | Painel Solar | 1
3 | Caixa Principal | 1
4 | PCB 1 | 1
5 | PCB 2 | 1
6 | Tampa inferior | 1
7 | Conector IP67 placa solar | 1

8 | Compartimento Sensor | 1
9 | Parafuso M5 | 4

TÍTULO: Módulo Explodido | A4

AUTOR | DATA
Pedro F. | 27/09/2019
PESO: | ESCALA:1:2.5 | FOLHA 1 DE 1

Produto educacional do SOLIDWORKS. Somente para fins de instrução.
