PI2-PLG/PLG-Docs/Documentos do Projeto/Energia/Projeto Nobreak.PDF

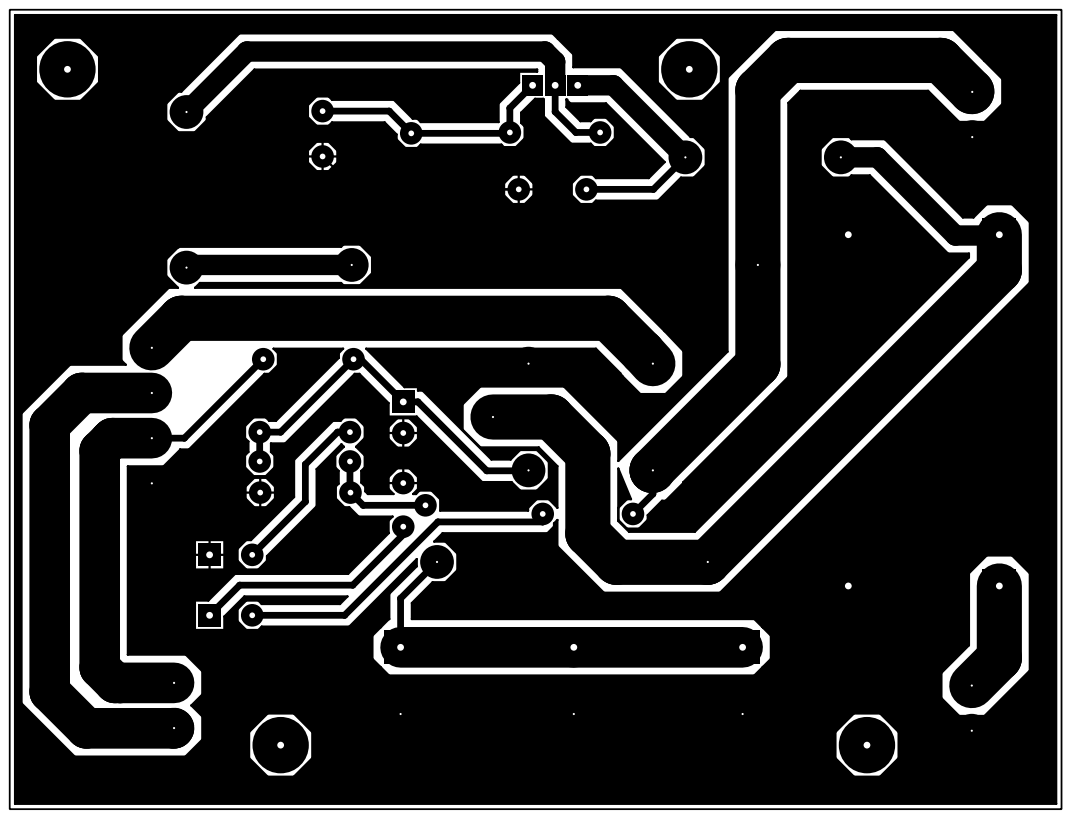
[picture p63: page 1]
