PI2-PLG/PLG-Docs/Documentos do Projeto/Software/Dados para comparação.pdf

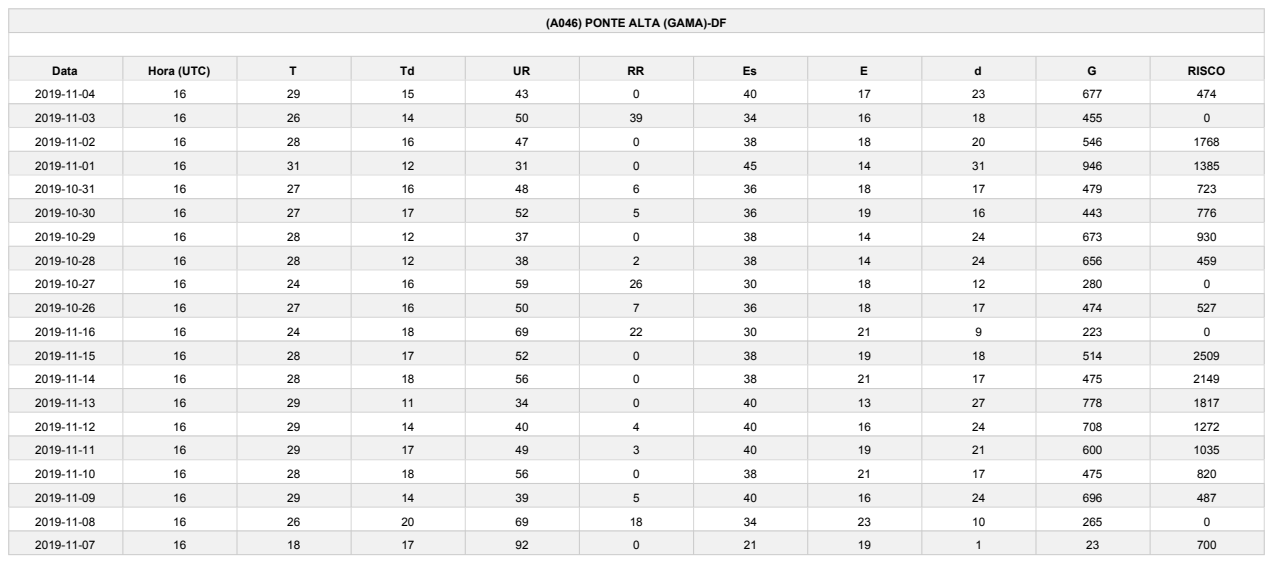
[picture p64: page 1]
Data; Hora (UTC); G RISCO

(A046) PONTE ALTA (GAMA)-DF
