PI2-PLG/PLG-Docs/Documentos do Projeto/Eletronica/Esquemáticos/placa_Principal.pdf

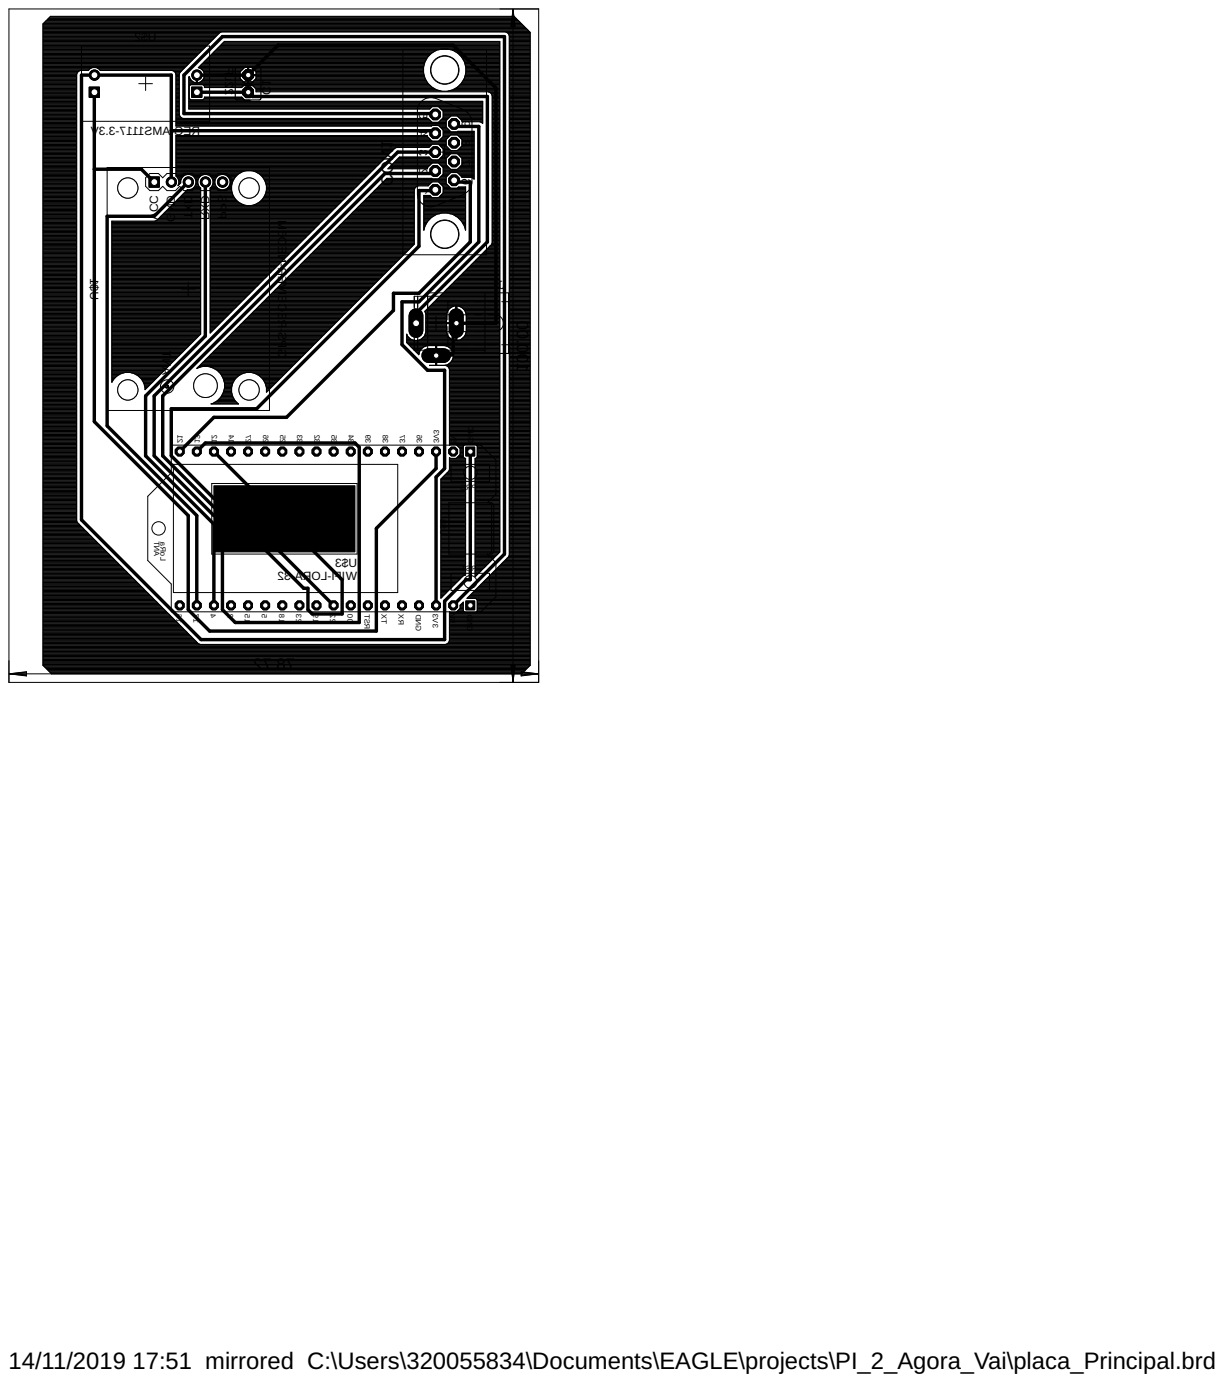
[picture p65: page 1]

14/11/2019 17:51 mirrored C:\Users\320055834\Documents\EAGLE\projects\PI_2_Agora_Vai\placa_Principal.brd
