PI2-PLG/PLG-Docs/Documentos do Projeto/Estrutura/Desenhos/Caixa Principal.PDF

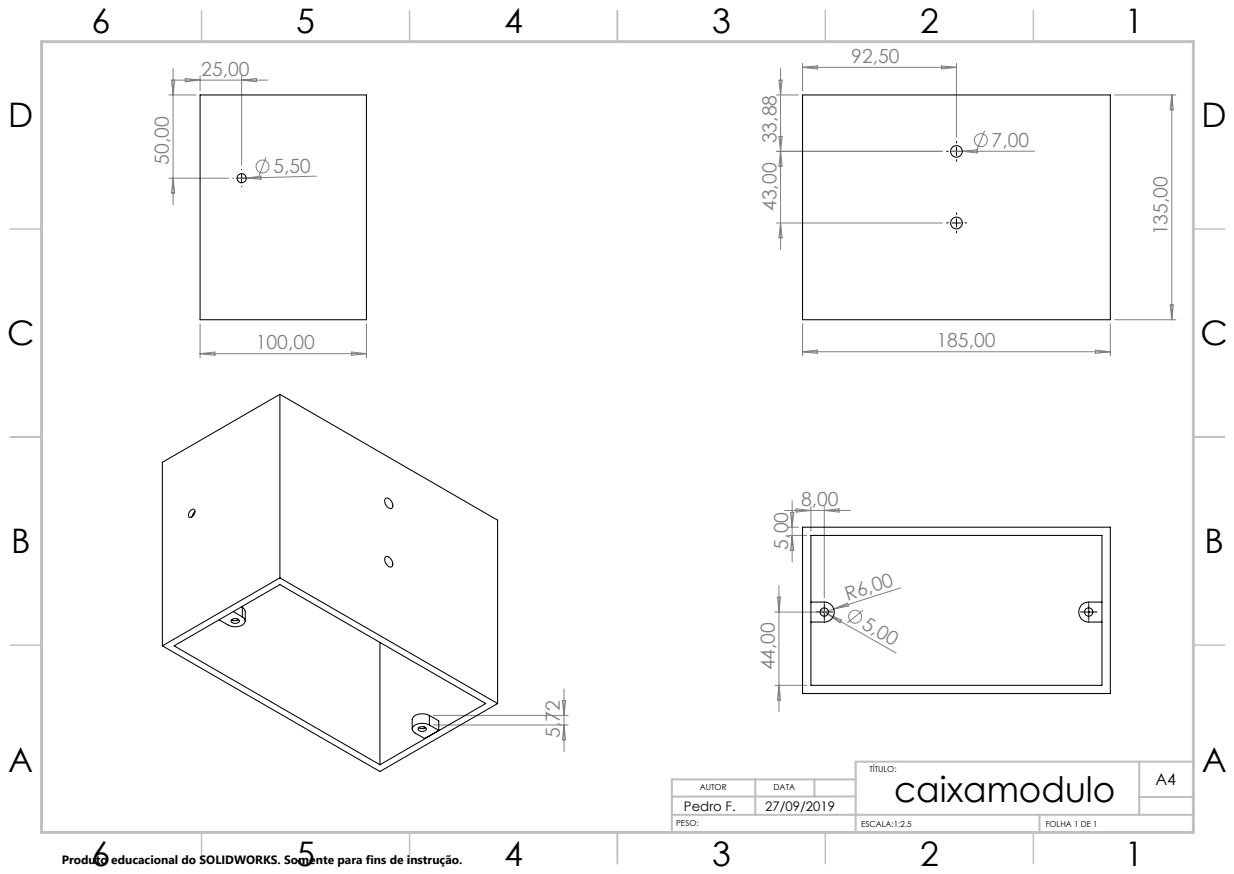
[picture p66: page 1]
ESCALA:1:2.5; FOLHA 1 DE 1

TÍTULO: caixamodulo | A4
Pedro F. AUTOR | 27/09/2019 DATA

Produto educacional do SOLIDWORKS. Somente para fins de instrução.
