PI2-PLG/PLG-Docs/Documentos do Projeto/Estrutura/Desenhos/Suporte Placa Solar.PDF

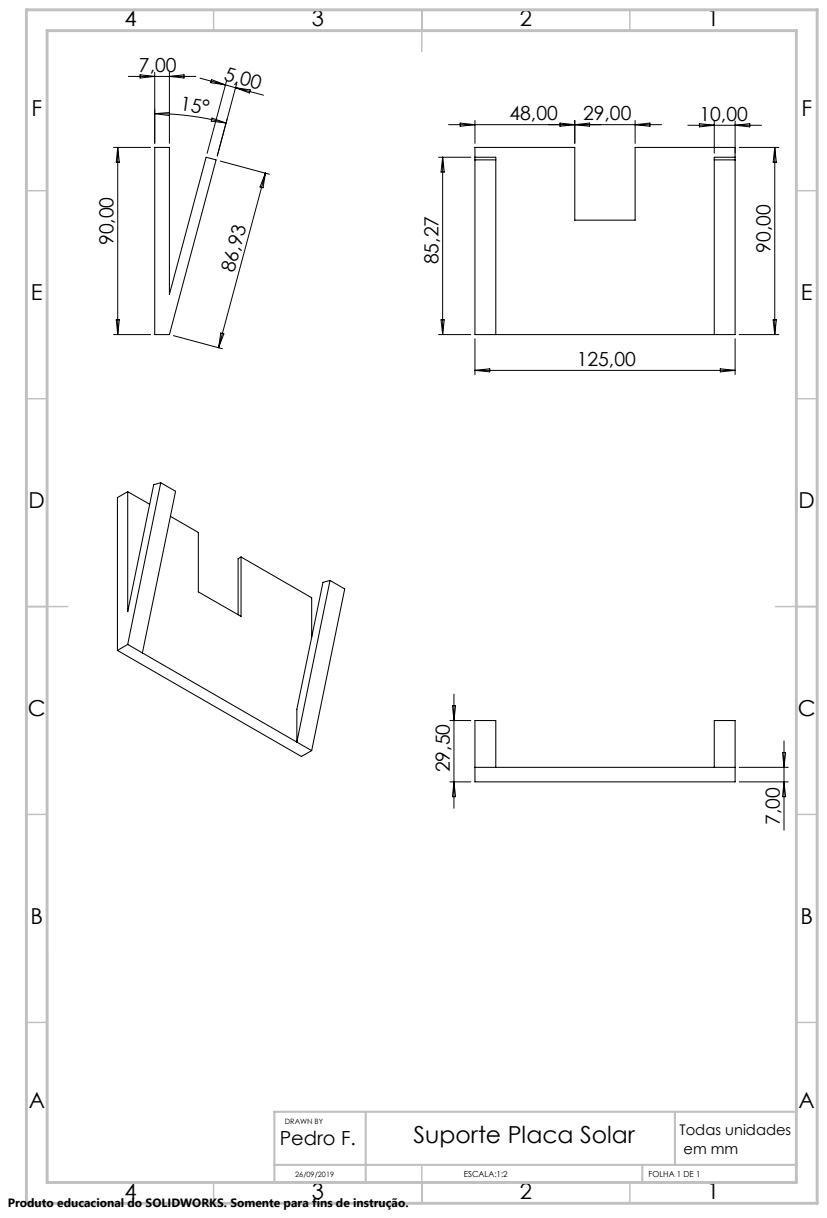
[picture p67: page 1]

DRAWN BY Pedro F. | Suporte Placa Solar | Todas unidades em mm

26/09/2019 | | ESCALA:1:2 | FOLHA 1 DE 1

Produto educacional do SOLIDWORKS. Somente para fins de instrução.
