PI2-PLG/PLG-Docs/Documentos do Projeto/Estrutura/Desenhos/Tampa Inferior.PDF

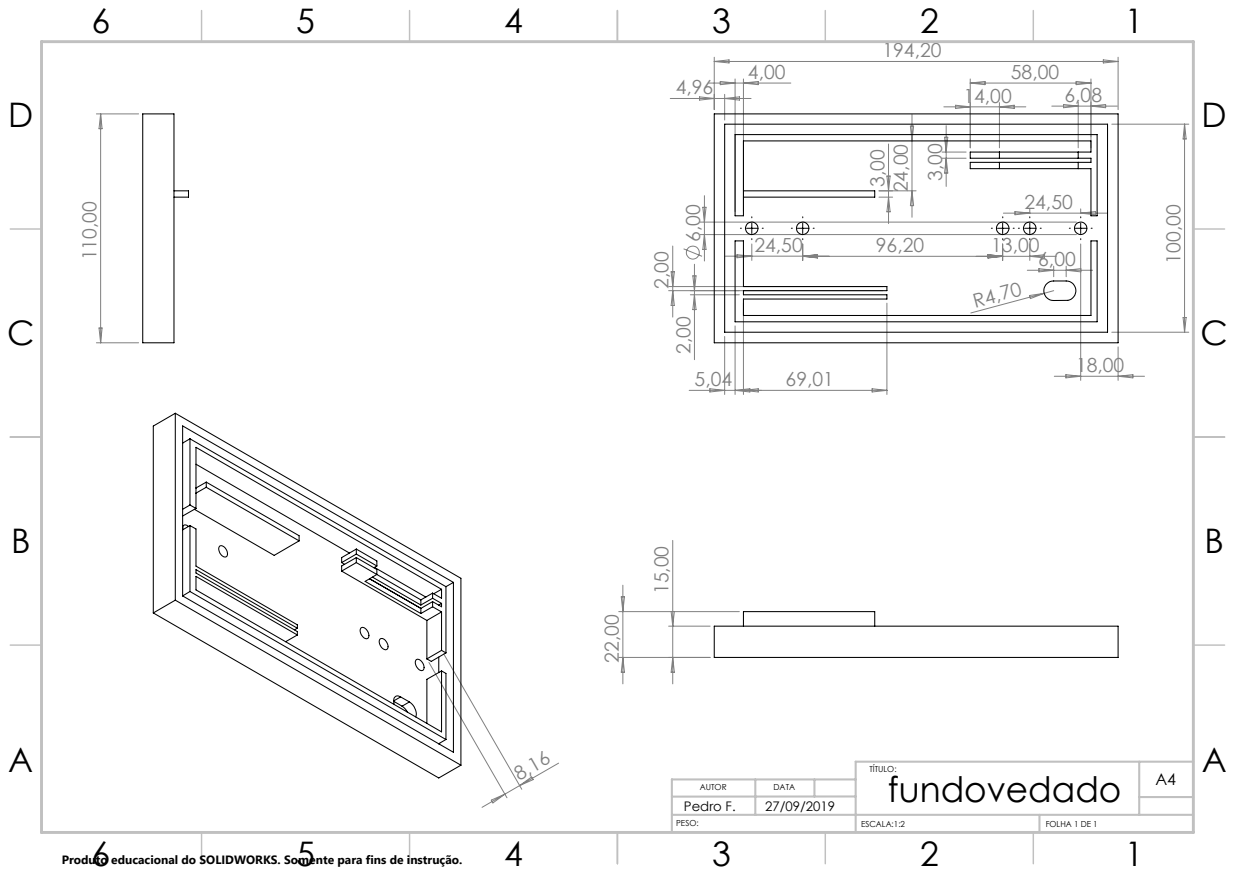
[picture p68: page 1]

TÍTULO: fundovedado | A4

AUTOR | DATA
Pedro F. | 27/09/2019
PESO: | ESCALA:1:2 | FOLHA 1 DE 1

Produto educacional do SOLIDWORKS. Somente para fins de instrução.
