PI2-PLG/PLG-Docs/(list of files, drawings)

Other design files:
Documentos do Projeto/Energia/Projeto Nobreak.pdsprj
