PI2-PLG/PLG-Docs/Documentos do Projeto/Eletronica/Esquemáticos/placa_Principal.sch

## EAGLE design Documentos do Projeto/Eletronica/Esquemáticos/placa_Principal.sch (2019-12-05)

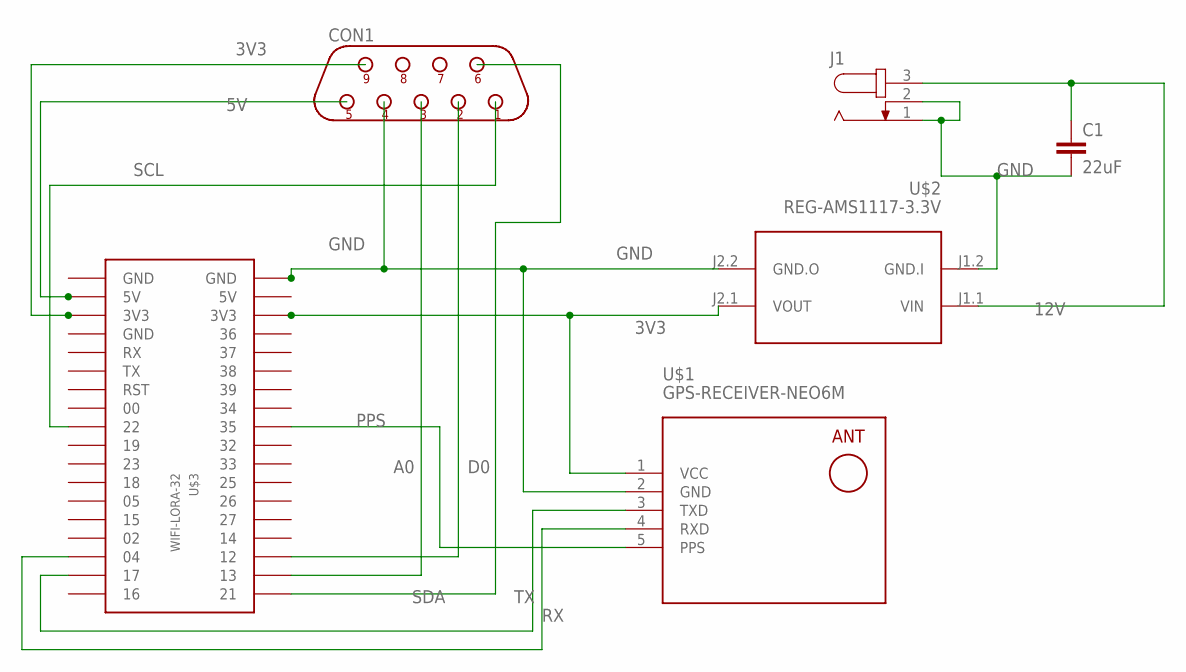
[picture p69: schematic placa_Principal.sch]

Parts:
C1: 22uF; C2.5-4
CON1: DB9F; D-09F
J1: JACK-PLUG1; SPC4078
U$1: GPS-RECEIVER-NEO6M
U$2: REG-AMS1117-3.3V; REG-AMS1117
U$3: WIFI-LORA-32; 2.54MM_2X18

Connections:
3V3: CON1.9, U$1.1 (VCC), U$2.J2.1 (VOUT), U$3.P$3 (3V3), U$3.P$34 (3V3)
5V: CON1.5, U$3.P$2 (5V)
12V: C1.1, J1.3, U$2.J1.1 (VIN)
A0: CON1.3, U$3.P$20 (13)
D0: CON1.2, U$3.P$21 (12)
GND: C1.2, CON1.4, J1.1, J1.2, U$1.2 (GND), U$2.J1.2 (GND.I), U$2.J2.2 (GND.O), U$3.P$36 (GND)
PPS: U$1.5 (PPS), U$3.P$28 (35)
RX: U$1.4 (RXD), U$3.P$16 (04)
SCL: CON1.1, U$3.P$9 (22)
SDA: CON1.6, U$3.P$19 (21)
TX: U$1.3 (TXD), U$3.P$17 (17)
