PI2-PLG/PLG-Docs/Documentos do Projeto/Eletronica/Esquemáticos/placa_sensores.sch

## EAGLE design Documentos do Projeto/Eletronica/Esquemáticos/placa_sensores.sch (2019-12-05)

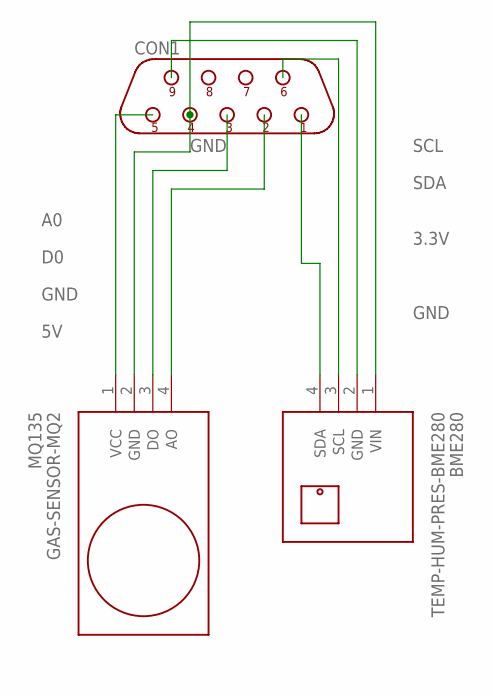
[picture p70: schematic placa_sensores.sch]

Parts:
BME280: TEMP-HUM-PRES-BME280
CON1: DB9F; D-09F
MQ135: GAS-SENSOR-MQ2

Connections:
3.3V: BME280.2 (GND), CON1.9
5V: CON1.5, MQ135.1 (VCC)
A0: CON1.2, MQ135.4 (AO)
D0: CON1.3, MQ135.3 (DO)
GND: BME280.1 (VIN), CON1.4, MQ135.2 (GND)
SCL: BME280.4 (SDA), CON1.1
SDA: BME280.3 (SCL), CON1.6
